vladkvit/orthograph_keyboard/right/updated--T-J24W167773A (W167773ASJ23)-ortho_right BOM  2020-12-2 (1).xls

5sets |  | updated | updated on the 1st, Feb | Designator | Package | Quantity | Designation | Specs | Value
$4.200 | $4.200 | IS31FL3733-TQLS4 5-7work days | IS31FL3733-TQLS4 5-7work days | U2 | TQFP-48-1EP_7x7mm_P0.5mm_EP5x5mm | 1 | IS31FL3733-TQ
$0.053 | $0.053 | 20K 0603 1% 1/10W，no 0.2W | 20K 0603 1% 1/10W，no 0.2W | Rext1 | R_0603_1608Metric_Pad1.05x0.95mm_HandSolder | 1 | R20k | 0.1W 1% | 20k
$0.053 | $0.105 | 1K 0603 1% 1/10W，no 0.2W | 1K 0603 1% 1/10W，no 0.2W | R5,R3 | R_0603_1608Metric_Pad1.05x0.95mm_HandSolder | 2 | R1k | 0.1W 5% | 1k
$0.053 | $0.158 | 100K 0603 1% 1/10W，no 0.2W | 100K 0603 1% 1/10W，no 0.2W | R4,R2,R1 | R_0603_1608Metric_Pad1.05x0.95mm_HandSolder | 3 | R100k | 0.1W 5% | 100k
$0.840 | $2.520 | TAJR104M035RNJ 5-7work days | TAJR104M035RNJ | C1,C4,C6 | C_0805_2012Metric_Pad1.15x1.40mm_HandSolder | 3 | CP | Tantalum, 5V, any ESR, any % | 0.1 microF
$0.735 | $2.205 | TAJR474M020RNJ 5-7work days | TAJR474M020RNJ | C2,C3,C5 | C_0805_2012Metric_Pad1.15x1.40mm_HandSolder | 3 | CP | Tantalum, 5V, any ESR, any % | 0.47 microF
$0.105 | $4.830 | LED Made in China RGB3528 Reversed https://es.aliexpress.com/item/32834911790.html | supply LED RGB3528 lighting face-down （LED敏感，建议发多点让客户替换） https://es.aliexpress.com/item/32834911790.html | K56A,K38A,K28A,K47A,K62A,K61A,K58A,K57A,K17A,K68A,K67A,K66A,K51A,K41A,K31A,K21A,K11A,K55A,K54A,K53A,K52A,K46A,K45A,K44A,K43A,K42A,K37A,K36A,K35A,K34A,K33A,K32A,K27A,K26A,K25A,K24A,K23A,K22A,K16A,K15A,K14A,K13A,K12A,K65A,K64A,K63A | RGB LED | 46 | KEYSW_RGB | RGB LED | RGB3528 Face-up
$0.063 | $2.898 | 1N4148W-TP | 1N4148W-TP | K56B,K38B,K28B,K47B,K62B,K61B,K58B,K57B,K17B,K68B,K67B,K66B,K51B,K41B,K31B,K21B,K11B,K55B,K54B,K53B,K52B,K46B,K45B,K44B,K43B,K42B,K37B,K36B,K35B,K34B,K33B,K32B,K27B,K26B,K25B,K24B,K23B,K22B,K16B,K15B,K14B,K13B,K12B,K65B,K64B,K63B | Diode | 46 | KEYSW_RGB | Diode | 1N4148W-TP
$0.945 | $0.945 | KMR231GLFS 7-10work days | KMR231GLFS 7-10work days | SW1 | SW_Push_1P1T_NO_CK_KMR2 | 1 | SW_PUSH_RESET | KMR231GLFS
$0.210 | $0.210 | PJ-320A DIP4 3.5mm | PJ-320A DIP4 3.5mm | J1 | TRRS-PJ-320A | 1 | AudioJack4 | TRRS-PJ-320A
0.5KG
 | $90.615
