vladkvit/orthograph_keyboard/left/updated-W167773ASJ20-5sets-ortho_half3 2020-8-24.xls

5sets |  | updated on 24th, August | Ref | Qnty | Value | Cmp name | Footprint | Description | Part number | Vendor
$0.105 | $0.630 | ceramic capacitor 100NF 50V 1206 | C1, C2, C3, C4, C5, C6, | 6 | 0.1 關F | CP | EIA-3216-10_Kemet-I_Pad1.58x1.35mm | Polarized capacitor Tantalum | Any | Any
$0.063 | $0.315 | 1N4148W-TP | K11, K21, K31, K41, K51, | 5 | 1N4148W-TP | Diode | SOD-123 | Diode | 1N4148W-TP | Any
$0.063 | $1.575 | 1N4148W-TP | K12, K13, K14, K15, K16, K22, K23, K24, K25, K26, K32, K33, K34, K35, K36, K42, K43, K44, K45, K46, K52, K53, K54, K55, K56, | 25 | 1N4148W-TP | Diode | SOD-123 | Diode | 1N4148W-TP | Any
$0.063 | $0.252 | 1N4148W-TP | K61, K62, K63, K64, | 4 | 1N4148W-TP | Diode | SOD-123 | Diode | 1N4148W-TP | Any
$0.063 | $0.063 | 1N4148W-TP | K65, | 1 | 1N4148W-TP | Diode | SOD-123 | Diode | 1N4148W-TP | Any
$0.063 | $0.063 | 1N4148W-TP | K66, | 1 | 1N4148W-TP | Diode | SOD-123 | Diode | 1N4148W-TP | Any
 | $0.000 | Out of stock | K11, K21, K31, K41, K51, | 5 | - | Kailh Socket | Custom | Socket | Kailh socket | Any or https://www.aliexpress.com/item/10000252734106.html
 | $0.000 | Out of stock | K12, K13, K14, K15, K16, K22, K23, K24, K25, K26, K32, K33, K34, K35, K36, K42, K43, K44, K45, K46, K52, K53, K54, K55, K56, | 25 | - | Kailh Socket | Custom | Socket | Kailh socket | Any or https://www.aliexpress.com/item/10000252734106.html
 | $0.000 | Out of stock | K61, K62, K63, K64, | 4 | - | Kailh Socket | Custom | Socket | Kailh socket | Any or https://www.aliexpress.com/item/10000252734106.html
 | $0.000 | Out of stock | K65, | 1 | - | Kailh Socket | Custom | Socket | Kailh socket | Any or https://www.aliexpress.com/item/10000252734106.html
 | $0.000 | Out of stock | K66, | 1 | - | Kailh Socket | Custom | Socket | Kailh socket | Any or https://www.aliexpress.com/item/10000252734106.html
$0.053 | $0.158 | 100K 0805 1% | R1, R2, R4, | 3 | R100k | R | 2012 | Resistor | Any | Any
$0.053 | $0.105 | 1K 0805 1% | R3, R5, | 2 | R1k | R | 2012 | Resistor | Any | Any
$0.053 | $0.053 | 20K 0805 1% | Rext1, | 1 | R20k | R | 2012 | Resistor | Any | Any
$0.525 | $0.525 | KMR231GLFS | SW1, | 1 | SW_Push_1P1T_NO_CK_KMR2 | SW_PUSH | 4.60mm x 2.80mm | Momentary Push button | KMR231GLFS or any KMR2 series | Any or https://www.aliexpress.com/item/4001159293893.html
$4.200 | $4.200 | IS31FL3733-TQLS4 贸泽 5-7work days | U2, | 1 | IS31FL3733-TQ | IS31FL3733-TQ | Package_QFP:TQFP-48-1EP_7x7mm_P0.5mm_EP5x5mm | 12x16 LED matrix driver with 8-bit PWM and breathing, TQFP-48 | IS31FL3733-TQ | Any or https://www.alibaba.com/product-detail/Integrated-Circuit-IS31FL3733-TQLS4-TR-_1600089956957.html
$0.210 | $0.210 | PJ-320A DIP4 3.5mm | J1 | 1 | TRRS-PJ-320A | TRRS-PJ-320A | Custom | Audio Jack | TRRS-PJ-320A | Any or https://www.aliexpress.com/item/33029465106.html
 |  |  | SUM | 87
 | $40.740
0.5KG
