vladkvit/orthograph_keyboard/left/svg/ortho_half-Eco2_User.dxf

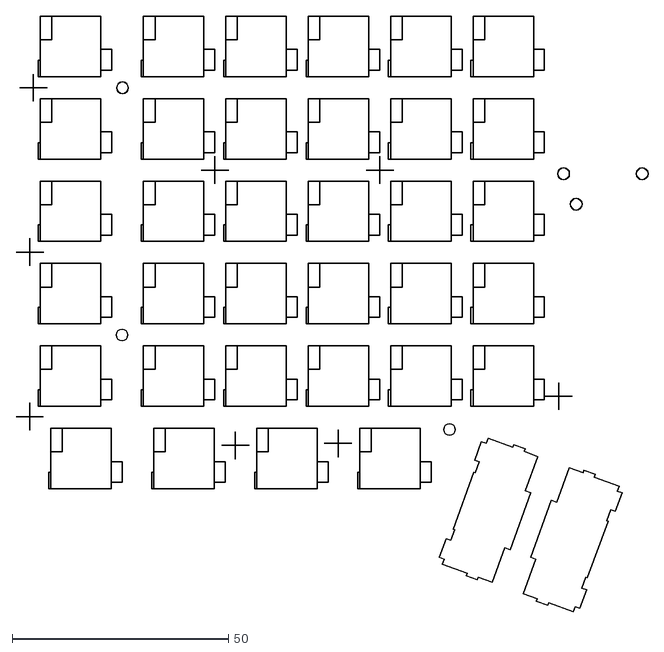
[picture p1: CAD file, 2022-06-20]
left/svg/ortho_half-Eco2_User.dxf
146.1 x 137.7
