vladkvit/orthograph_keyboard/right/ortho_right.step

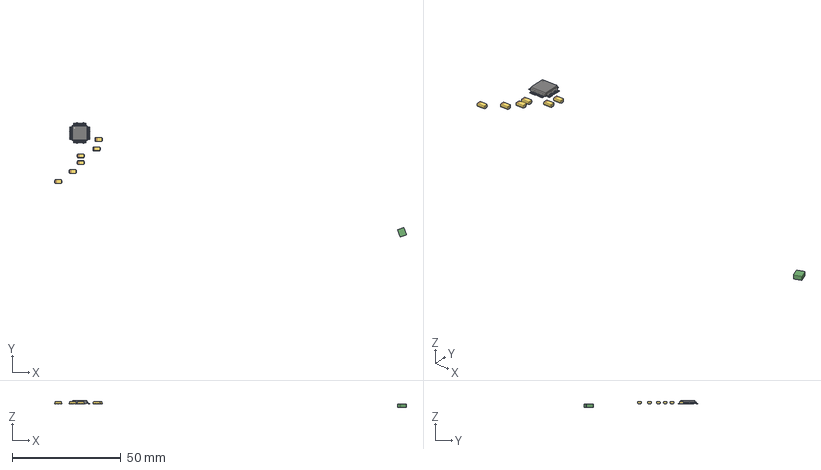
[picture p2: CAD file, 2020-11-28]
right/ortho_right.step
161.8 x 52.4 x 3.25 mm
