vladkvit/orthograph_keyboard/right/out/ortho_right-NPTH-drl_map.dxf

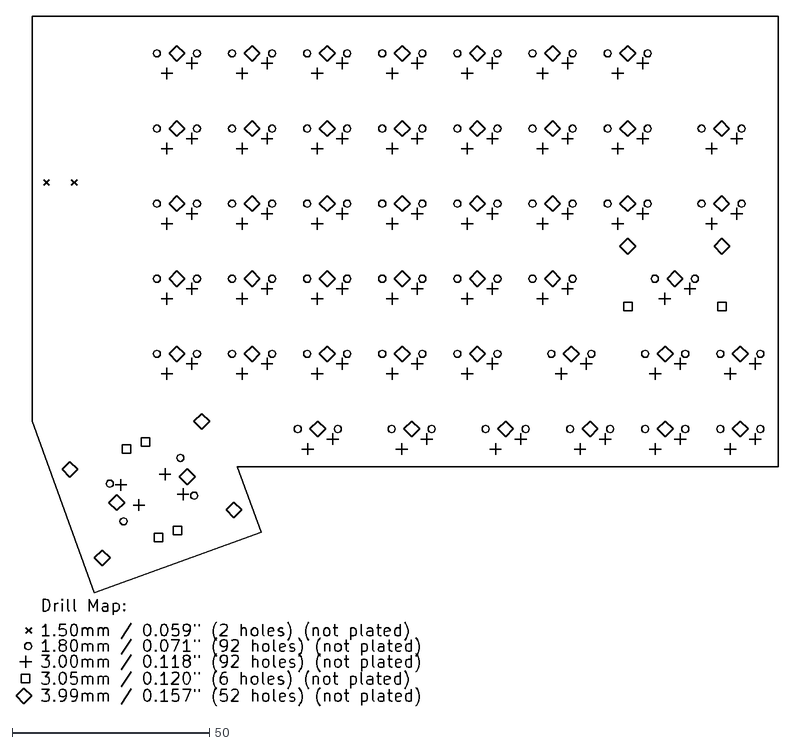
[picture p3: CAD file, 2021-03-09]
right/out/ortho_right-NPTH-drl_map.dxf
193.2 x 174.8
