vladkvit/orthograph_keyboard/left/svg/ortho_half-Edge_Cuts.dxf

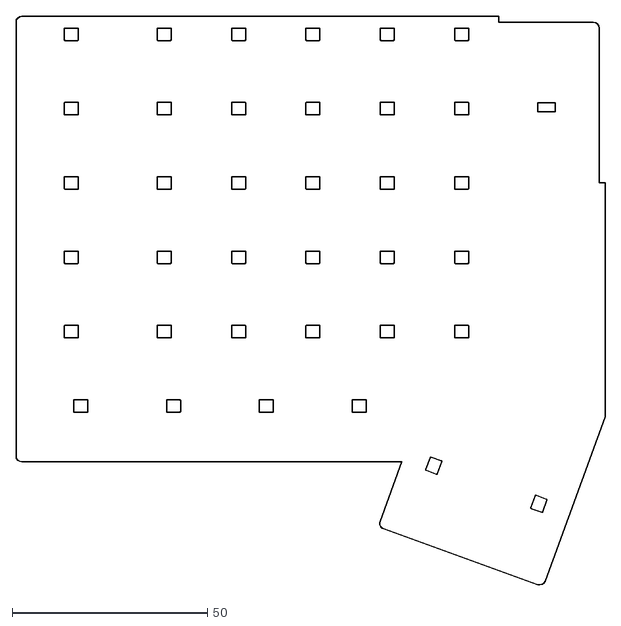
[picture p4: CAD file, 2022-06-20]
left/svg/ortho_half-Edge_Cuts.dxf
150.9 x 145.9
