vladkvit/orthograph_keyboard/right/out/ortho_right-Edge_Cuts.dxf

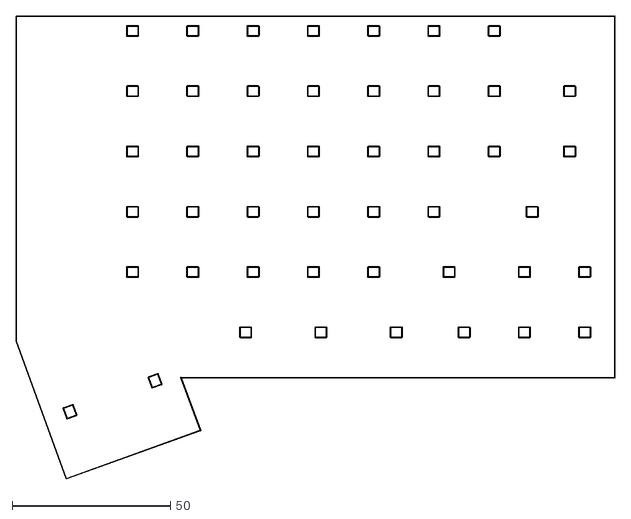
[picture p5: CAD file, 2021-03-09]
right/out/ortho_right-Edge_Cuts.dxf
189.3 x 146.2
