vladkvit/orthograph_keyboard/right/out/ortho_right-PTH-drl_map.dxf

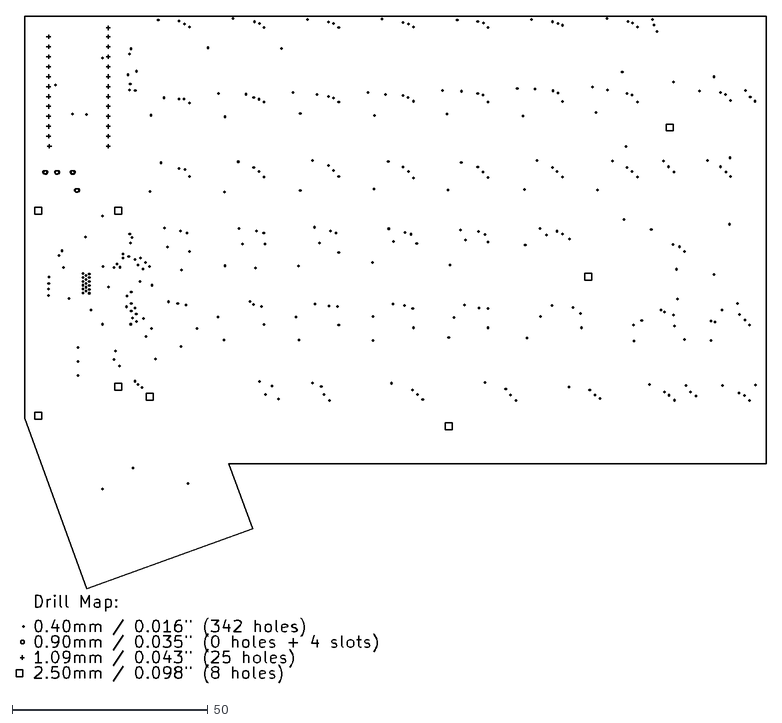
[picture p6: CAD file, 2021-03-09]
right/out/ortho_right-PTH-drl_map.dxf
191.4 x 170.2
