vladkvit/orthograph_keyboard/right/out/ortho_right-Eco2_User.dxf

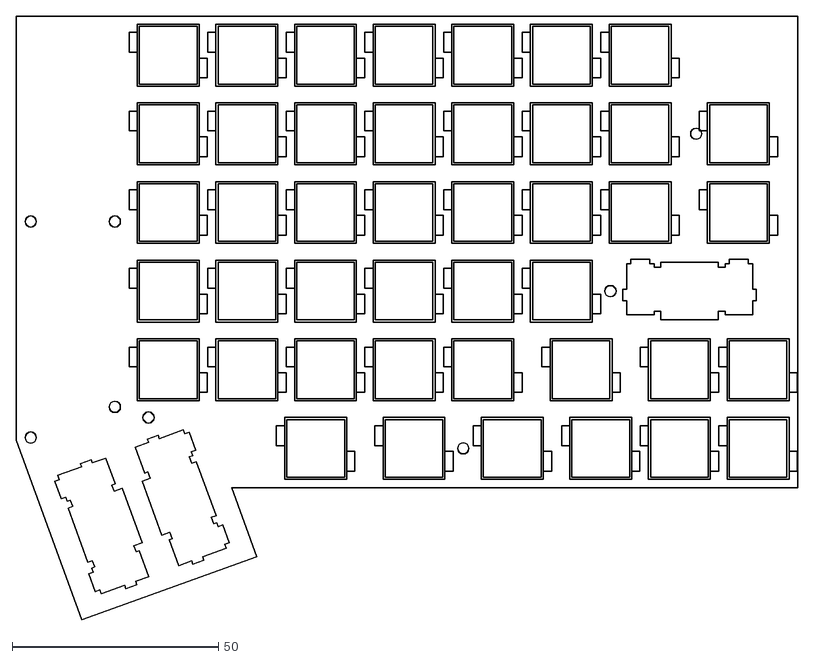
[picture p7: CAD file, 2021-03-09]
right/out/ortho_right-Eco2_User.dxf
189.2 x 146.1
