vladkvit/orthograph_keyboard/right/out/ortho_right-Edge_Cuts inkscape.dxf

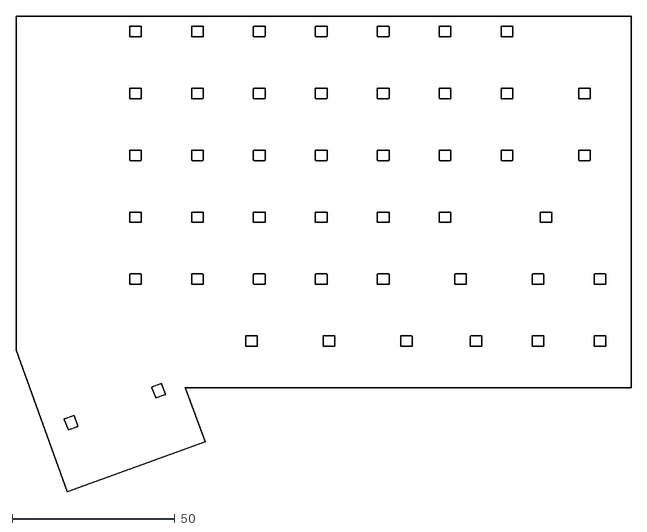
[picture p8: CAD file, 2021-03-09]
right/out/ortho_right-Edge_Cuts inkscape.dxf
189.2 x 146.1
