vladkvit/orthograph_keyboard/(list of files, cad)

Other CAD files:
left/frame schematics/bottom v2.dwg
spacer.dwg
bottom.dwg
plate.dwg
