vladkvit/orthograph_keyboard/left/frame schematics/bottom Drawing, extra hole, final part.pdf

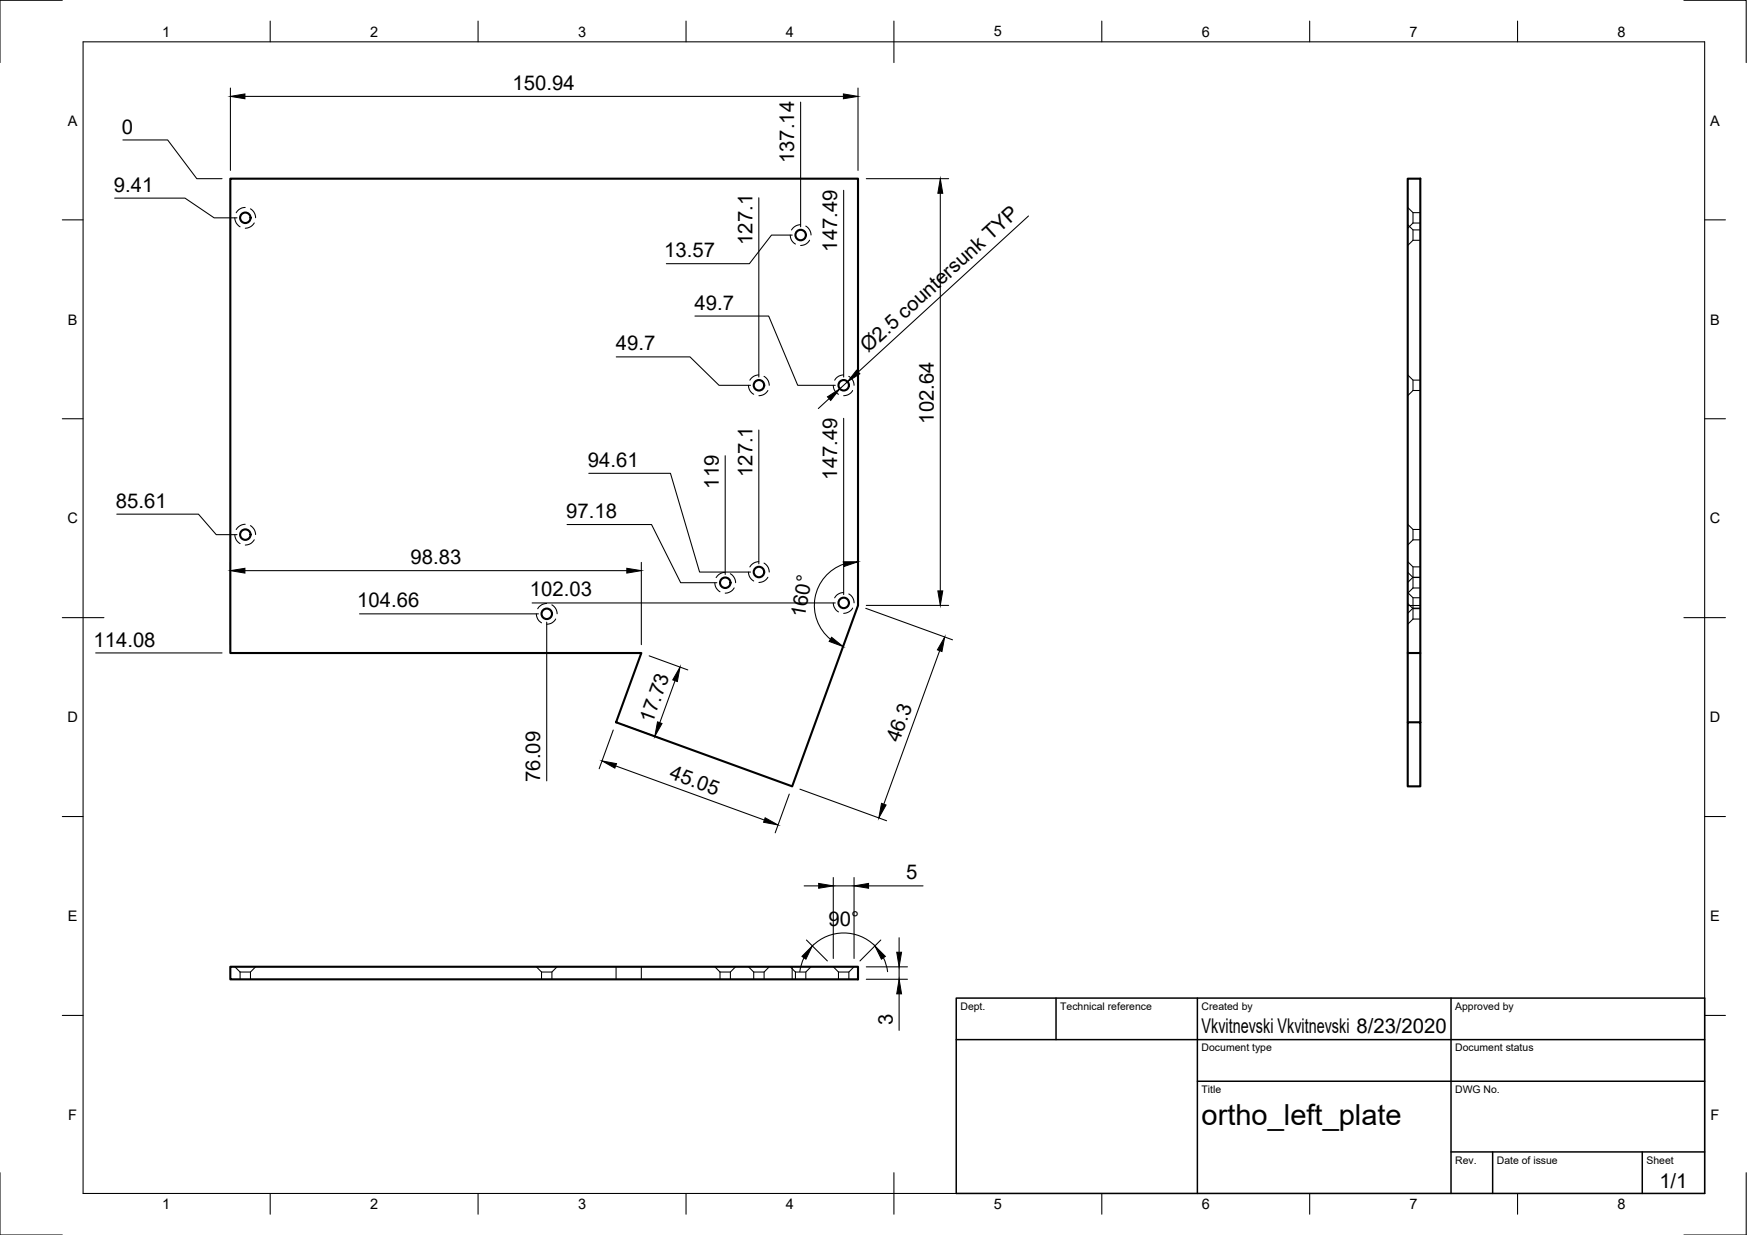
[picture p9: page 1]
Ø2.5 countersunk TYP

Dept. | Technical reference | Created by Vkvitnevski Vkvitnevski 8/23/2020 | Approved by

Document type | Document status

Title ortho_left_plate | DWG No.

Rev. | Date of issue | Sheet 1/1
