vladkvit/orthograph_keyboard/left/frame schematics/ortho_left_plate Drawing spacer.pdf

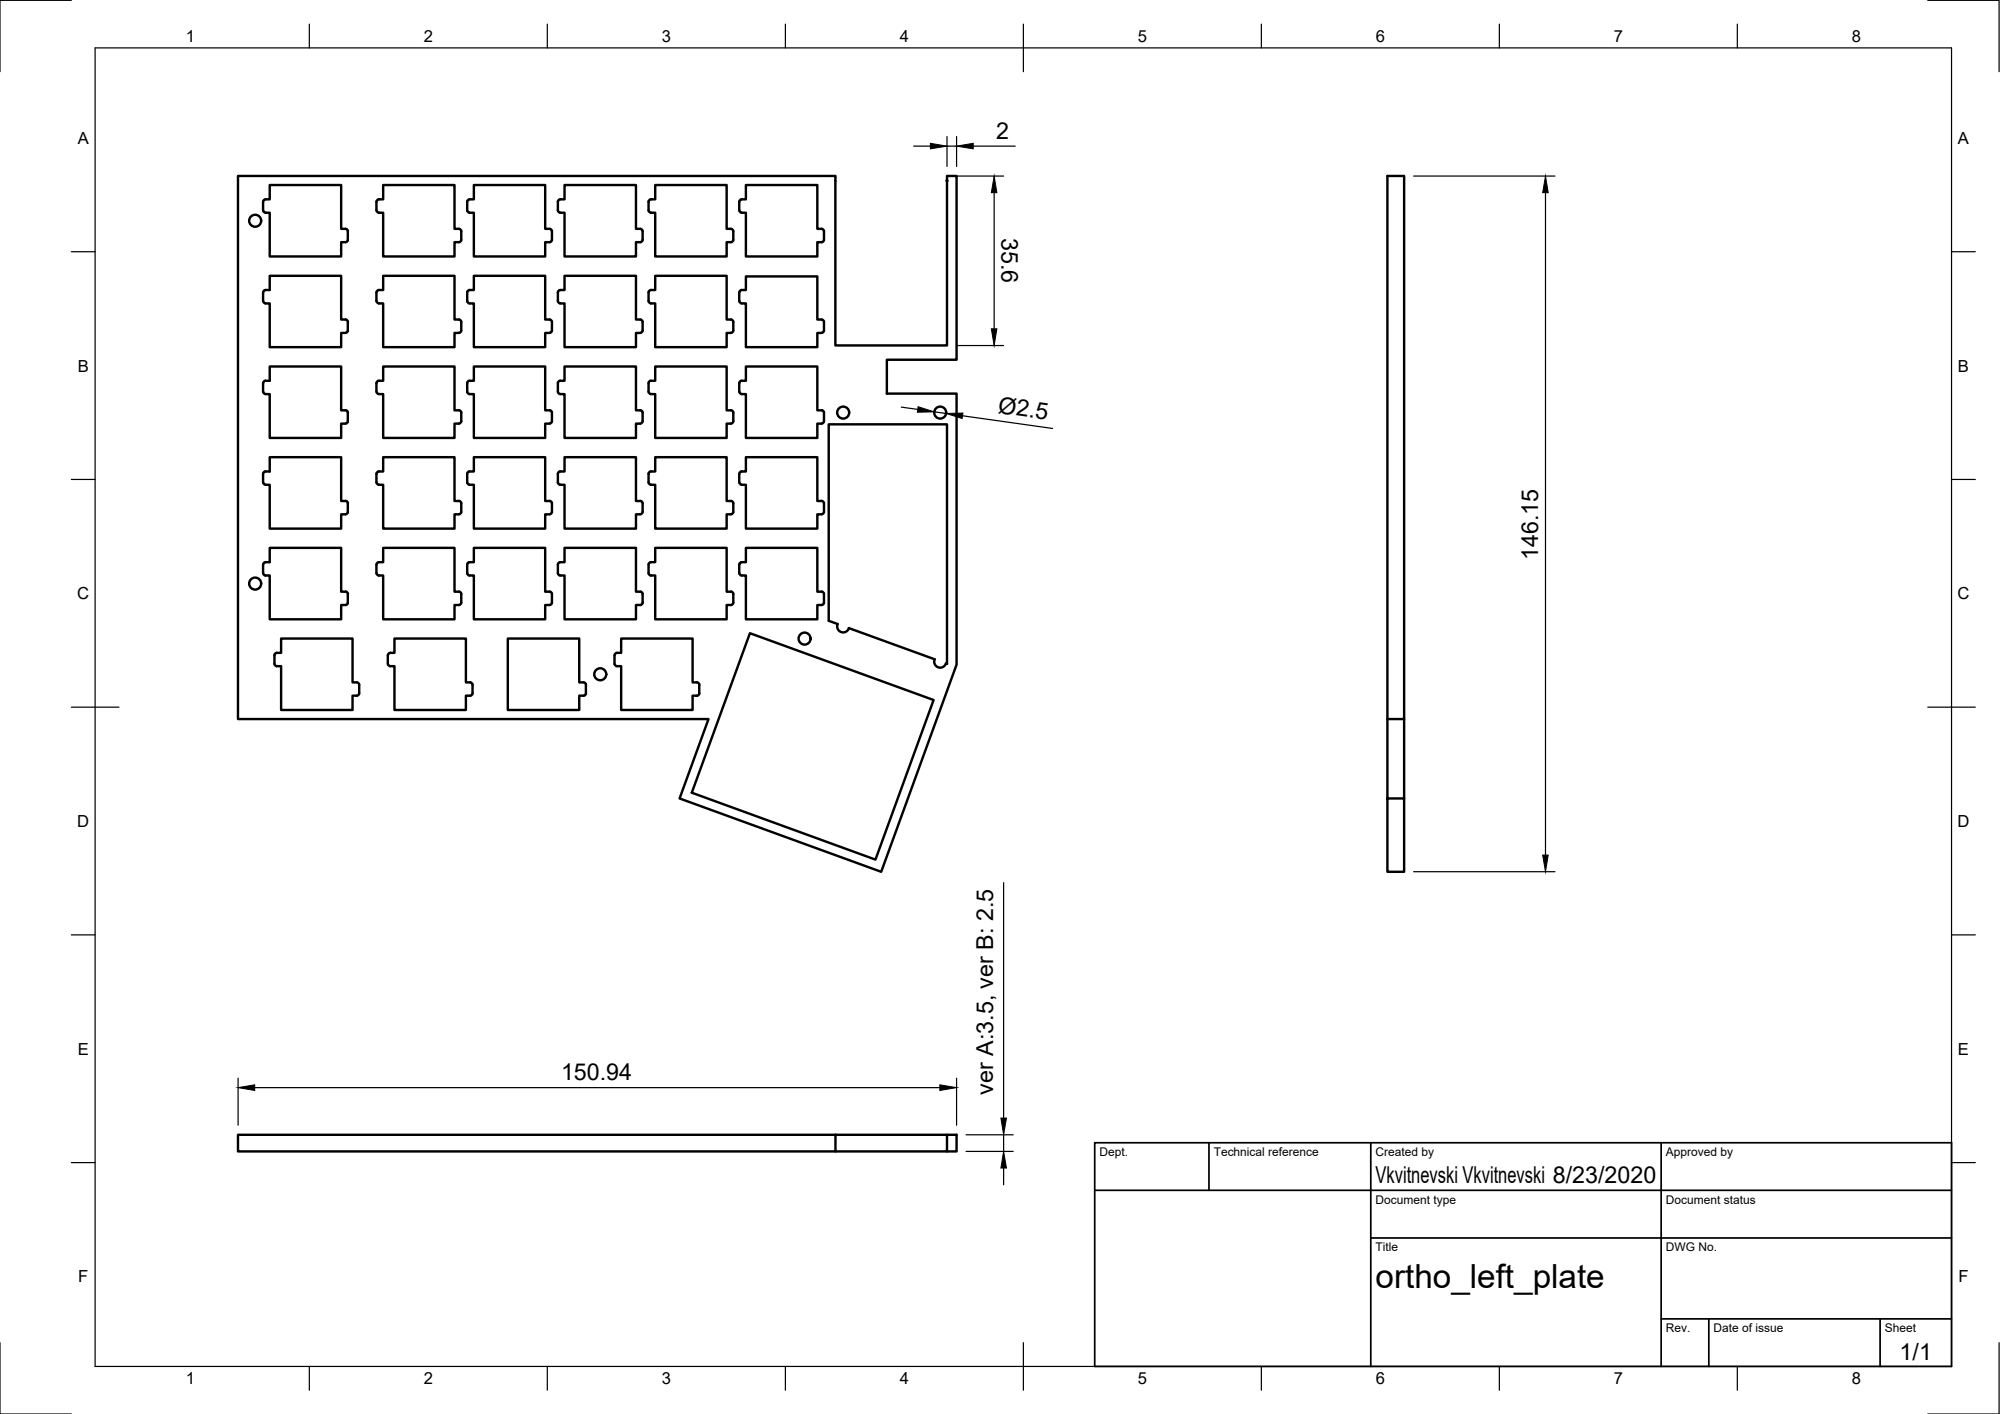
[picture p10: page 1]
146.15 ver A:3.5, ver B: 2.5

Dept. | Technical reference | Created by Vkvitnevski Vkvitnevski 8/23/2020 | Approved by

Document type | Document status

Title ortho_left_plate | DWG No.

Rev. | Date of issue | Sheet 1/1
