vladkvit/orthograph_keyboard/left/ortho_half.kicad_pcb

## KiCad design left/ortho_half.kicad_pcb (2025-12-19)

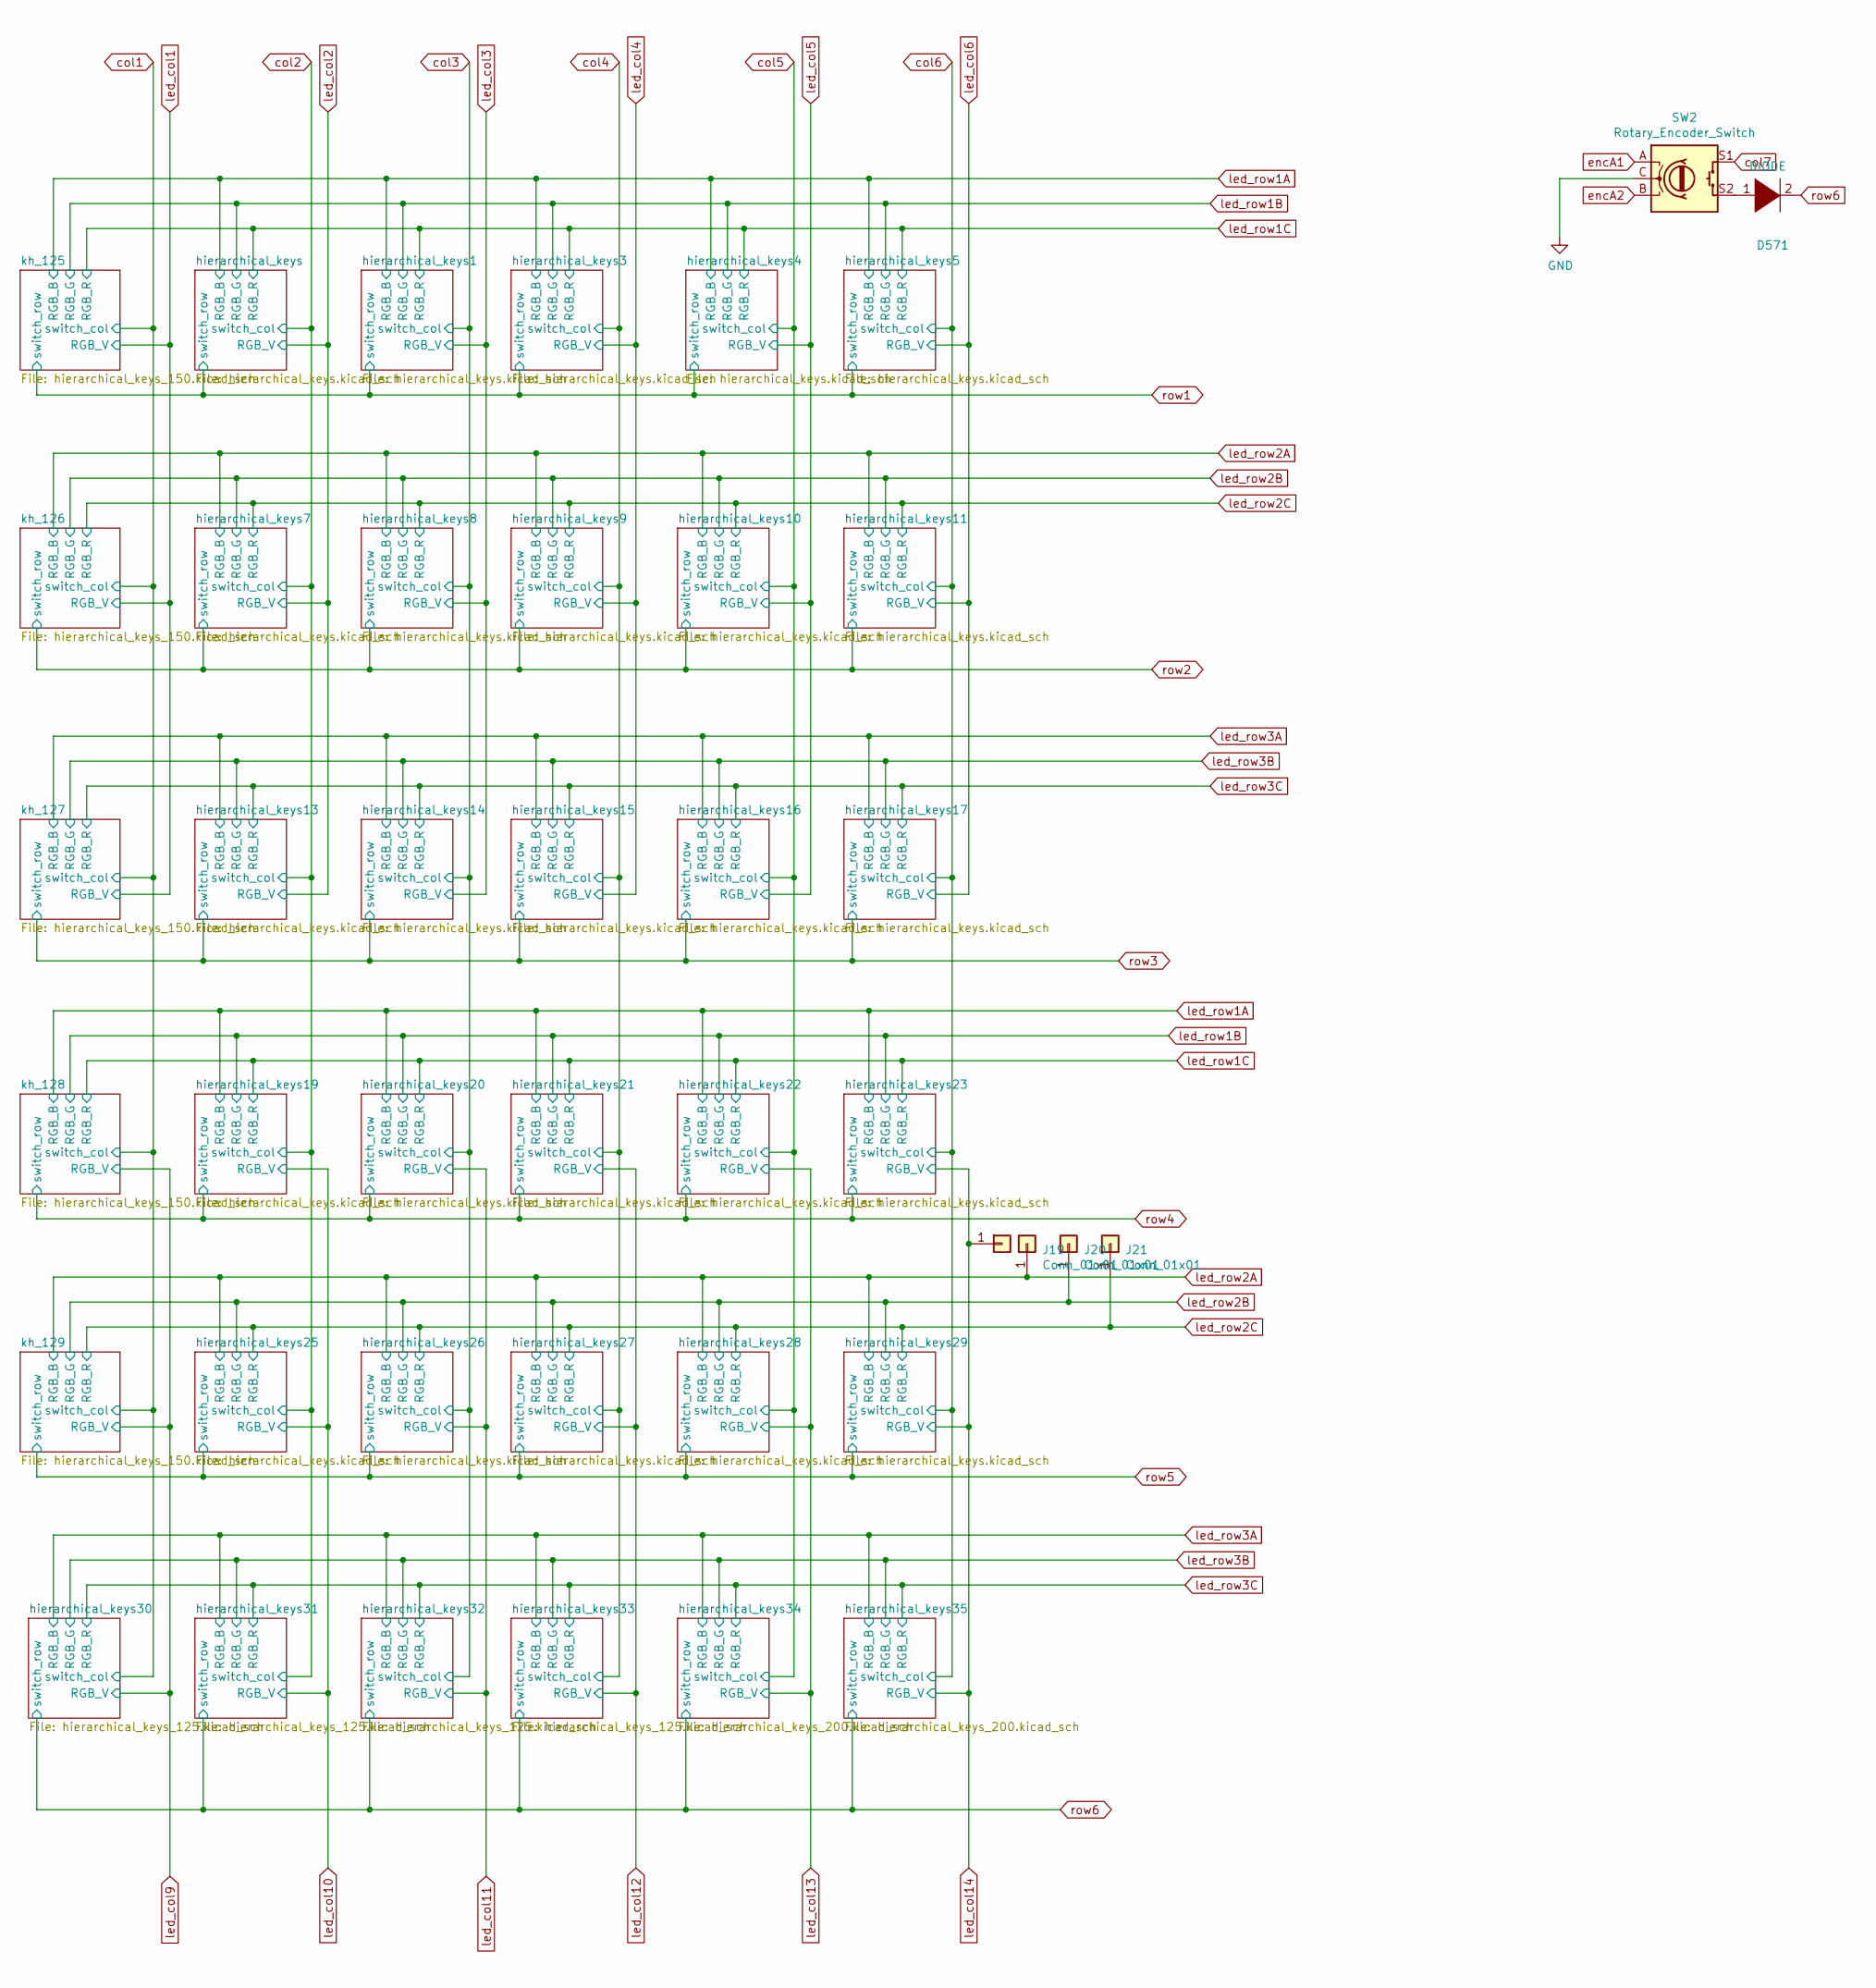
[picture p11: schematic switches.kicad_sch]

Parts:
D571: DIODE; D_SOD-123; LCSC C77978
J18, J19, J20, J21: Conn_01x01; TestPoint_Pad_D1.5mm
SW2: Rotary_Encoder_Switch; RotaryEncoderEC11_MX_combo; LCSC C470742

Connections:
GND: SW2.C; also elsewhere on the board
unnamed: D571.1 (K), SW2.S2
col7: SW2.S1; also elsewhere on the board
encA1: SW2.A; also elsewhere on the board
encA2: SW2.B; also elsewhere on the board
led_col14: J18.1; also elsewhere on the board
led_row2A: J19.1; also elsewhere on the board
led_row2B: J20.1; also elsewhere on the board
led_row2C: J21.1; also elsewhere on the board
row6: D571.2 (A); also elsewhere on the board

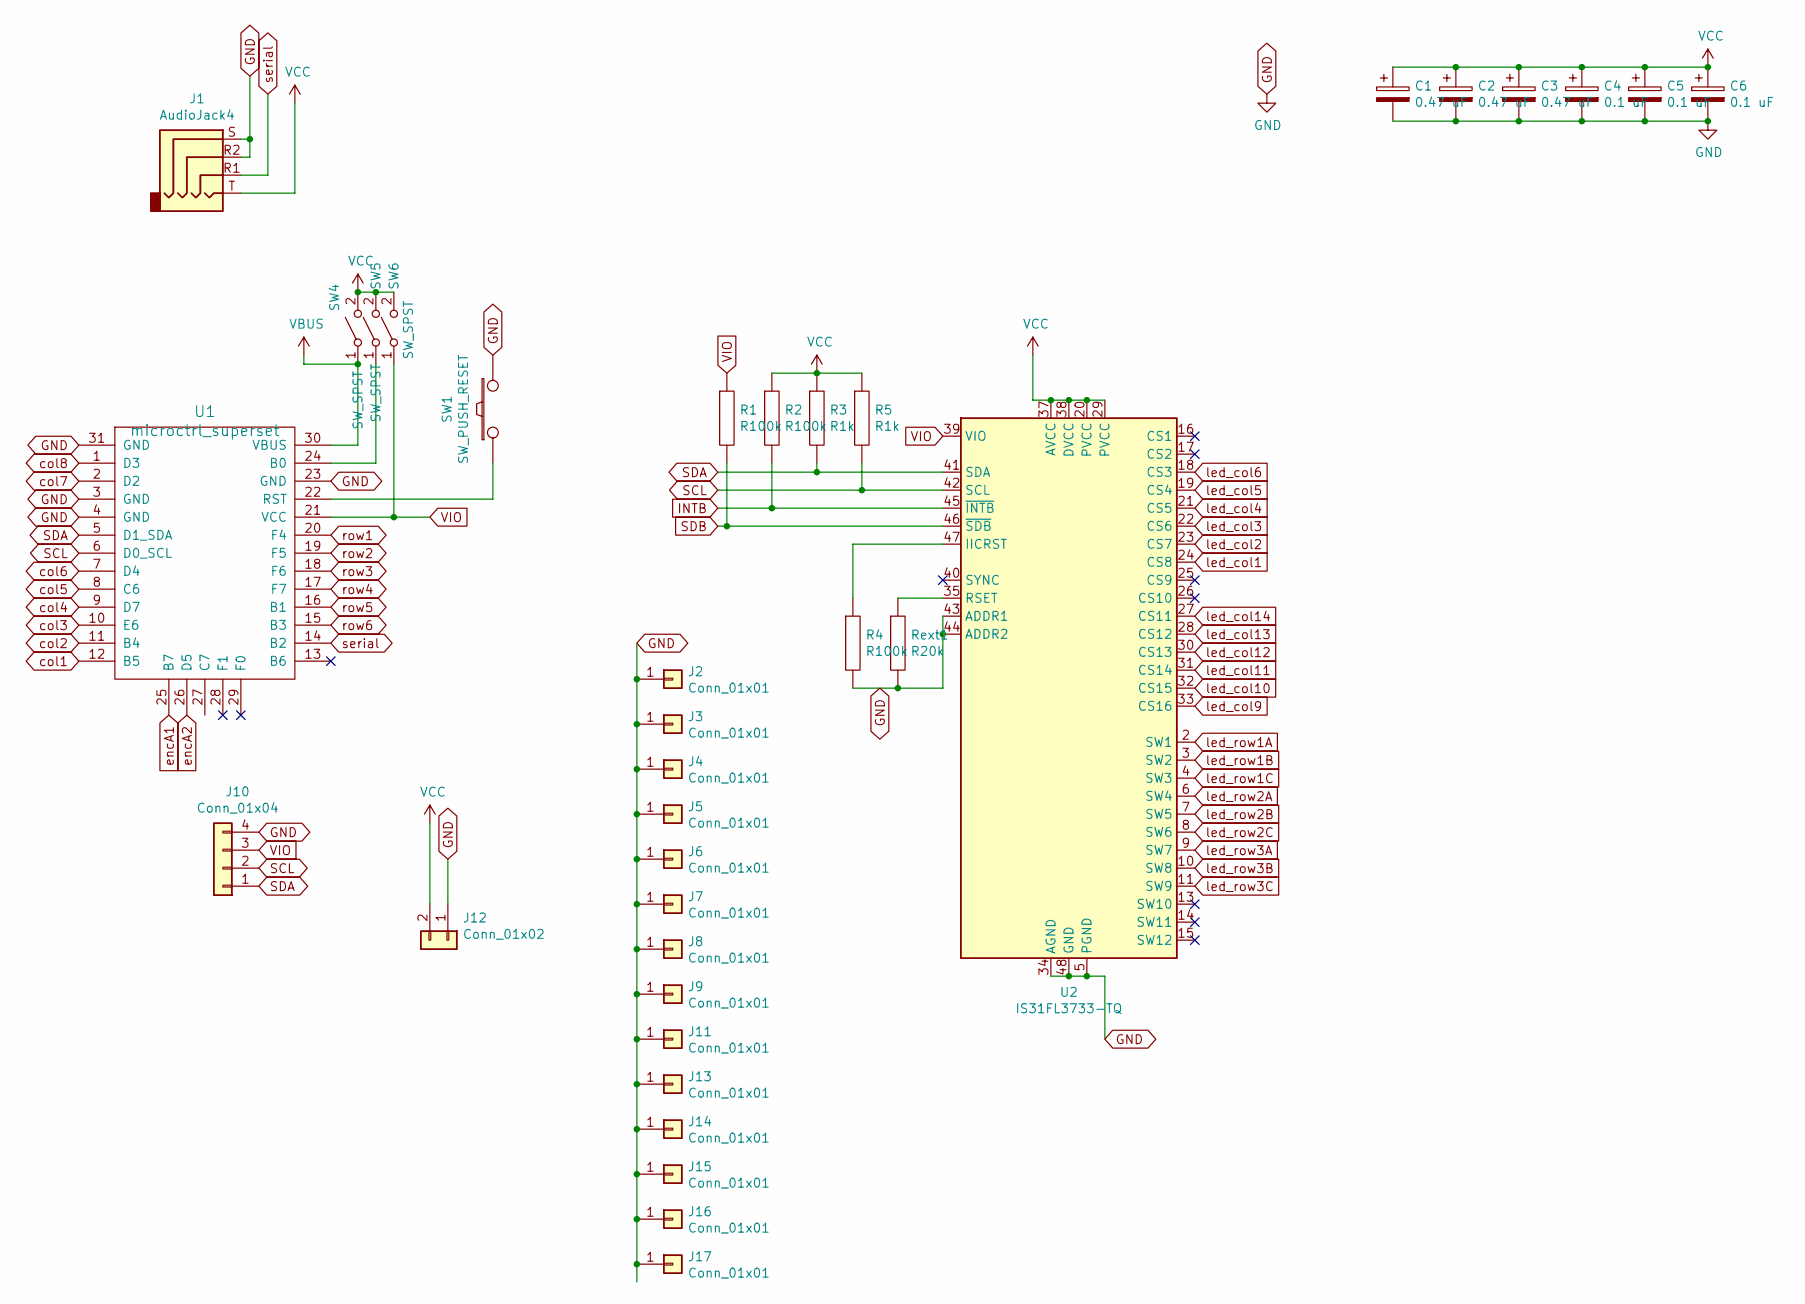
[picture p12: schematic Controller.kicad_sch]

Parts:
C1, C2, C3: 0.47 uF; C_0805_2012Metric; LCSC C49955
C4, C5, C6: 0.1 uF; C_0805_2012Metric; LCSC C49678
J1: AudioJack4; TRRS-PJ-320D; LCSC C431535
J2, J3, J5, J6, J7, J9, J11, J17: Conn_01x01; SMTSO_mount_m2.5; LCSC C2916379
J4, J8: Conn_01x01; m2.5_hole
J10: Conn_01x04; PinHeader_1x04_P2.54mm_Vertical
J12: Conn_01x02; battery_solder_point
J13, J14, J15, J16: Conn_01x01; standoff_m2.5
R1, R2, R4: R100k; R_0603_1608Metric; LCSC C25803
R3, R5: R1k; R_0603_1608Metric; LCSC C21190
Rext1: R20k; R_0603_1608Metric; LCSC C4184
SW1: SW_PUSH_RESET; SW_Push_1P1T_NO_CK_KMR2; LCSC C99271
SW4, SW5, SW6: SW_SPST; SolderJumper-2_P1.3mm_Open_RoundedPad1.0x1.5mm
U1: microctrl_superset; microcontroller_eliteC_ninenano
U2: IS31FL3733-TQ; TQFP-48-1EP_7x7mm_P0.5mm_EP5x5mm; LCSC C17348851

Connections:
GND: C1.2, C2.2, C3.2, C4.2, C5.2, C6.2, J1.R2, J1.S, J2.1, J3.1, J4.1, J5.1, J6.1, J7.1, J8.1, J9.1, J10.4, J11.1, J12.1, J13.1, J14.1, J15.1, J16.1, J17.1, R4.2, Rext1.2, SW1.2, U1.3 (GND), U1.4 (GND), U1.23 (GND), U1.31 (GND), U2.5 (PGND), U2.12 (PGND), U2.34 (AGND), U2.43 (ADDR1), U2.44 (ADDR2), U2.48 (GND), U2.49 (GND); also elsewhere on the board
INTB: R2.2, U2.45 (~INTB)
unnamed: SW5.1 (A), U1.24 (B0)
unnamed: SW1.1, U1.22 (RST)
unnamed: R4.1, U2.47 (IICRST)
unnamed: Rext1.1, U2.35 (RSET)
SCL: J10.2, R5.2, U1.6 (D0_SCL), U2.42 (SCL)
SDA: J10.1, R3.2, U1.5 (D1_SDA), U2.41 (SDA)
SDB: R1.2, U2.46 (~SDB)
VBUS: SW4.1 (A), U1.30 (VBUS)
VCC: C1.1, C2.1, C3.1, C4.1, C5.1, C6.1, J1.T, J12.2, R2.1, R3.1, R5.1, SW4.2 (B), SW5.2 (B), SW6.2 (B), U2.20 (PVCC), U2.29 (PVCC), U2.37 (AVCC), U2.38 (DVCC)
VIO: J10.3, R1.1, SW6.1 (A), U1.21 (VCC), U2.39 (VIO)
col1: U1.12 (B5); also elsewhere on the board
col2: U1.11 (B4); also elsewhere on the board
col3: U1.10 (E6); also elsewhere on the board
col4: U1.9 (D7); also elsewhere on the board
col5: U1.8 (C6); also elsewhere on the board
col6: U1.7 (D4); also elsewhere on the board
col7: U1.2 (D2); also elsewhere on the board
col8: U1.1 (D3)
encA1: U1.25 (B7); also elsewhere on the board
encA2: U1.26 (D5); also elsewhere on the board
led_col1: U2.24 (CS8); also elsewhere on the board
led_col2: U2.23 (CS7); also elsewhere on the board
led_col3: U2.22 (CS6); also elsewhere on the board
led_col4: U2.21 (CS5); also elsewhere on the board
led_col5: U2.19 (CS4); also elsewhere on the board
led_col6: U2.18 (CS3); also elsewhere on the board
led_col9: U2.33 (CS16); also elsewhere on the board
led_col10: U2.32 (CS15); also elsewhere on the board
led_col11: U2.31 (CS14); also elsewhere on the board
led_col12: U2.30 (CS13); also elsewhere on the board
led_col13: U2.28 (CS12); also elsewhere on the board
led_col14: U2.27 (CS11); also elsewhere on the board
led_row1A: U2.2 (SW1); also elsewhere on the board
led_row1B: U2.3 (SW2); also elsewhere on the board
led_row1C: U2.4 (SW3); also elsewhere on the board
led_row2A: U2.6 (SW4); also elsewhere on the board
led_row2B: U2.7 (SW5); also elsewhere on the board
led_row2C: U2.8 (SW6); also elsewhere on the board
led_row3A: U2.9 (SW7); also elsewhere on the board
led_row3B: U2.10 (SW8); also elsewhere on the board
led_row3C: U2.11 (SW9); also elsewhere on the board
row1: U1.20 (F4); also elsewhere on the board
row2: U1.19 (F5); also elsewhere on the board
row3: U1.18 (F6); also elsewhere on the board
row4: U1.17 (F7); also elsewhere on the board
row5: U1.16 (B1); also elsewhere on the board
row6: U1.15 (B3); also elsewhere on the board
serial: J1.R1, U1.14 (B2)

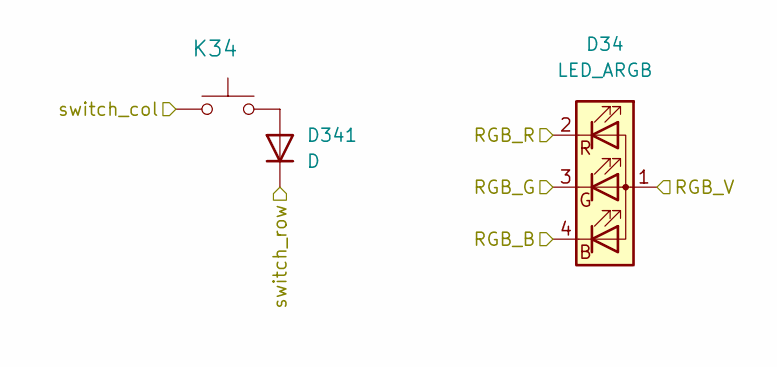
[picture p13: schematic hierarchical_keys.kicad_sch]

Parts:
D34: LED_ARGB; MX_RGB
D341: D; D_SOD-123
K34: KEYSW; MX_switch_hotswap

Connections:
unnamed: D341.2 (A), K34.2
col4: K34.1; also elsewhere on the board
led_col4: D34.1 (A); also elsewhere on the board
led_row3A: D34.4 (BK); also elsewhere on the board
led_row3B: D34.3 (GK); also elsewhere on the board
led_row3C: D34.2 (RK); also elsewhere on the board
row3: D341.1 (K); also elsewhere on the board

Parts of its further copies:
D12, D13, D14, D15, D16, D22, D23, D24, D25, D26, D32, D33, D35, D36, D42, D43, D44, D45, D46, D52, D53, D54, D55, D56, D61, D62, D63, D64, D65, D66: LED_ARGB; MX_RGB
D121, D131, D141, D151, D161, D221, D231, D241, D251, D261, D321, D331, D351, D361, D421, D431, D441, D451, D461, D521, D531, D541, D551, D561, D611, D621, D631, D641, D651, D661: D; D_SOD-123
K12, K13, K14, K15, K16, K22, K23, K24, K25, K26, K32, K33, K35, K36, K42, K43, K44, K45, K46, K52, K53, K54, K55, K56, K61, K62, K63, K64, K65, K66: KEYSW; MX_switch_hotswap

Connections of its further copies:
unnamed: D121.2 (A), K12.2
unnamed: D131.2 (A), K13.2
unnamed: D141.2 (A), K14.2
unnamed: D151.2 (A), K15.2
unnamed: D161.2 (A), K16.2
unnamed: D221.2 (A), K22.2
unnamed: D231.2 (A), K23.2
unnamed: D241.2 (A), K24.2
unnamed: D251.2 (A), K25.2
unnamed: D261.2 (A), K26.2
unnamed: D321.2 (A), K32.2
unnamed: D331.2 (A), K33.2
unnamed: D351.2 (A), K35.2
unnamed: D361.2 (A), K36.2
unnamed: D421.2 (A), K42.2
unnamed: D431.2 (A), K43.2
unnamed: D441.2 (A), K44.2
unnamed: D451.2 (A), K45.2
unnamed: D461.2 (A), K46.2
unnamed: D521.2 (A), K52.2
unnamed: D531.2 (A), K53.2
unnamed: D541.2 (A), K54.2
unnamed: D551.2 (A), K55.2
unnamed: D561.2 (A), K56.2
unnamed: D611.2 (A), K61.2
unnamed: D621.2 (A), K62.2
unnamed: D631.2 (A), K63.2
unnamed: D641.2 (A), K64.2
unnamed: D651.2 (A), K65.2
unnamed: D661.2 (A), K66.2
col1: K61.1; also elsewhere on the board
col2: K12.1, K22.1, K32.1, K42.1, K52.1, K62.1; also elsewhere on the board
col3: K13.1, K23.1, K33.1, K43.1, K53.1, K63.1; also elsewhere on the board
col4: K14.1, K24.1, K44.1, K54.1, K64.1; also elsewhere on the board
col5: K15.1, K25.1, K35.1, K45.1, K55.1, K65.1; also elsewhere on the board
col6: K16.1, K26.1, K36.1, K46.1, K56.1, K66.1; also elsewhere on the board
led_col2: D12.1 (A), D22.1 (A), D32.1 (A); also elsewhere on the board
led_col3: D13.1 (A), D23.1 (A), D33.1 (A); also elsewhere on the board
led_col4: D14.1 (A), D24.1 (A); also elsewhere on the board
led_col5: D15.1 (A), D25.1 (A), D35.1 (A); also elsewhere on the board
led_col6: D16.1 (A), D26.1 (A), D36.1 (A); also elsewhere on the board
led_col9: D61.1 (A); also elsewhere on the board
led_col10: D42.1 (A), D52.1 (A), D62.1 (A); also elsewhere on the board
led_col11: D43.1 (A), D53.1 (A), D63.1 (A); also elsewhere on the board
led_col12: D44.1 (A), D54.1 (A), D64.1 (A); also elsewhere on the board
led_col13: D45.1 (A), D55.1 (A), D65.1 (A); also elsewhere on the board
led_col14: D46.1 (A), D56.1 (A), D66.1 (A); also elsewhere on the board
led_row1A: D12.4 (BK), D13.4 (BK), D14.4 (BK), D15.4 (BK), D16.4 (BK), D42.4 (BK), D43.4 (BK), D44.4 (BK), D45.4 (BK), D46.4 (BK); also elsewhere on the board
led_row1B: D12.3 (GK), D13.3 (GK), D14.3 (GK), D15.3 (GK), D16.3 (GK), D42.3 (GK), D43.3 (GK), D44.3 (GK), D45.3 (GK), D46.3 (GK); also elsewhere on the board
led_row1C: D12.2 (RK), D13.2 (RK), D14.2 (RK), D15.2 (RK), D16.2 (RK), D42.2 (RK), D43.2 (RK), D44.2 (RK), D45.2 (RK), D46.2 (RK); also elsewhere on the board
led_row2A: D22.4 (BK), D23.4 (BK), D24.4 (BK), D25.4 (BK), D26.4 (BK), D52.4 (BK), D53.4 (BK), D54.4 (BK), D55.4 (BK), D56.4 (BK); also elsewhere on the board
led_row2B: D22.3 (GK), D23.3 (GK), D24.3 (GK), D25.3 (GK), D26.3 (GK), D52.3 (GK), D53.3 (GK), D54.3 (GK), D55.3 (GK), D56.3 (GK); also elsewhere on the board
led_row2C: D22.2 (RK), D23.2 (RK), D24.2 (RK), D25.2 (RK), D26.2 (RK), D52.2 (RK), D53.2 (RK), D54.2 (RK), D55.2 (RK), D56.2 (RK); also elsewhere on the board
led_row3A: D32.4 (BK), D33.4 (BK), D35.4 (BK), D36.4 (BK), D61.4 (BK), D62.4 (BK), D63.4 (BK), D64.4 (BK), D65.4 (BK), D66.4 (BK); also elsewhere on the board
led_row3B: D32.3 (GK), D33.3 (GK), D35.3 (GK), D36.3 (GK), D61.3 (GK), D62.3 (GK), D63.3 (GK), D64.3 (GK), D65.3 (GK), D66.3 (GK); also elsewhere on the board
led_row3C: D32.2 (RK), D33.2 (RK), D35.2 (RK), D36.2 (RK), D61.2 (RK), D62.2 (RK), D63.2 (RK), D64.2 (RK), D65.2 (RK), D66.2 (RK); also elsewhere on the board
row1: D121.1 (K), D131.1 (K), D141.1 (K), D151.1 (K), D161.1 (K); also elsewhere on the board
row2: D221.1 (K), D231.1 (K), D241.1 (K), D251.1 (K), D261.1 (K); also elsewhere on the board
row3: D321.1 (K), D331.1 (K), D351.1 (K), D361.1 (K); also elsewhere on the board
row4: D421.1 (K), D431.1 (K), D441.1 (K), D451.1 (K), D461.1 (K); also elsewhere on the board
row5: D521.1 (K), D531.1 (K), D541.1 (K), D551.1 (K), D561.1 (K); also elsewhere on the board
row6: D611.1 (K), D621.1 (K), D631.1 (K), D641.1 (K), D651.1 (K), D661.1 (K); also elsewhere on the board

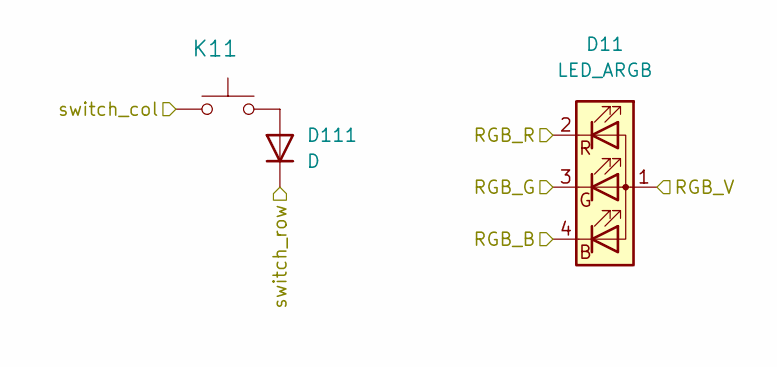
[picture p14: schematic hierarchical_keys_150.kicad_sch]

Parts:
D11: LED_ARGB; MX_RGB
D111: D; D_SOD-123
K11: KEYSW; MX_switch_hotswap_150

Connections:
unnamed: D111.2 (A), K11.2
col1: K11.1; also elsewhere on the board
led_col1: D11.1 (A); also elsewhere on the board
led_row1A: D11.4 (BK); also elsewhere on the board
led_row1B: D11.3 (GK); also elsewhere on the board
led_row1C: D11.2 (RK); also elsewhere on the board
row1: D111.1 (K); also elsewhere on the board

Parts of its further copies:
D21, D41, D51: LED_ARGB; MX_RGB
D211, D411, D511: D; D_SOD-123
K21, K41, K51: KEYSW; MX_switch_hotswap_150

Connections of its further copies:
unnamed: D211.2 (A), K21.2
unnamed: D411.2 (A), K41.2
unnamed: D511.2 (A), K51.2
col1: K21.1, K41.1, K51.1; also elsewhere on the board
led_col1: D21.1 (A); also elsewhere on the board
led_col9: D41.1 (A), D51.1 (A); also elsewhere on the board
led_row1A: D41.4 (BK); also elsewhere on the board
led_row1B: D41.3 (GK); also elsewhere on the board
led_row1C: D41.2 (RK); also elsewhere on the board
led_row2A: D21.4 (BK), D51.4 (BK); also elsewhere on the board
led_row2B: D21.3 (GK), D51.3 (GK); also elsewhere on the board
led_row2C: D21.2 (RK), D51.2 (RK); also elsewhere on the board
row2: D211.1 (K); also elsewhere on the board
row4: D411.1 (K); also elsewhere on the board
row5: D511.1 (K); also elsewhere on the board

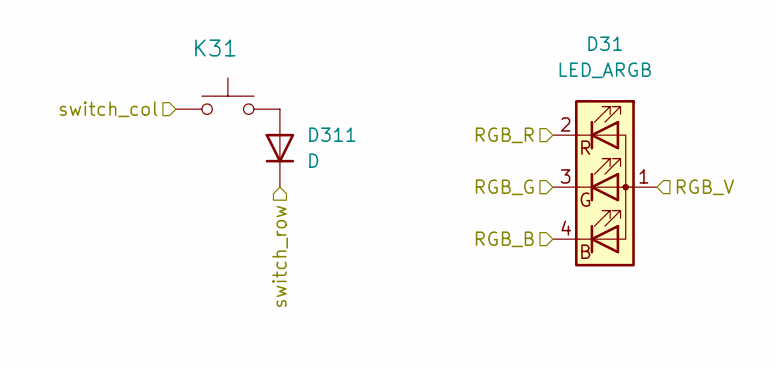
[picture p15: schematic hierarchical_keys_200.kicad_sch]

Parts:
D31: LED_ARGB; MX_RGB
D311: D; D_SOD-123
K31: KEYSW; MX_switch_hotswap_200

Connections:
unnamed: D311.2 (A), K31.2
col1: K31.1; also elsewhere on the board
led_col1: D31.1 (A); also elsewhere on the board
led_row3A: D31.4 (BK); also elsewhere on the board
led_row3B: D31.3 (GK); also elsewhere on the board
led_row3C: D31.2 (RK); also elsewhere on the board
row3: D311.1 (K); also elsewhere on the board

Parts of its further copies:
D21, D41, D51, D65, D66: LED_ARGB; MX_RGB
D211, D411, D511, D651, D661: D; D_SOD-123
K21, K41, K51, K65, K66: KEYSW; MX_switch_hotswap_200

Connections of its further copies:
unnamed: D211.2 (A), K21.2
unnamed: D411.2 (A), K41.2
unnamed: D511.2 (A), K51.2
unnamed: D651.2 (A), K65.2
unnamed: D661.2 (A), K66.2
col1: K21.1, K41.1, K51.1; also elsewhere on the board
col5: K65.1; also elsewhere on the board
col6: K66.1; also elsewhere on the board
led_col1: D21.1 (A); also elsewhere on the board
led_col9: D41.1 (A), D51.1 (A); also elsewhere on the board
led_col13: D65.1 (A); also elsewhere on the board
led_col14: D66.1 (A); also elsewhere on the board
led_row1A: D41.4 (BK); also elsewhere on the board
led_row1B: D41.3 (GK); also elsewhere on the board
led_row1C: D41.2 (RK); also elsewhere on the board
led_row2A: D21.4 (BK), D51.4 (BK); also elsewhere on the board
led_row2B: D21.3 (GK), D51.3 (GK); also elsewhere on the board
led_row2C: D21.2 (RK), D51.2 (RK); also elsewhere on the board
led_row3A: D65.4 (BK), D66.4 (BK); also elsewhere on the board
led_row3B: D65.3 (GK), D66.3 (GK); also elsewhere on the board
led_row3C: D65.2 (RK), D66.2 (RK); also elsewhere on the board
row2: D211.1 (K); also elsewhere on the board
row4: D411.1 (K); also elsewhere on the board
row5: D511.1 (K); also elsewhere on the board
row6: D651.1 (K), D661.1 (K); also elsewhere on the board


Parts:
D31: LED_ARGB; MX_RGB
D311: D; D_SOD-123
K31: KEYSW; MX_switch_hotswap_125

Connections:
unnamed: D311.2 (A), K31.2
col1: K31.1; also elsewhere on the board
led_col1: D31.1 (A); also elsewhere on the board
led_row3A: D31.4 (BK); also elsewhere on the board
led_row3B: D31.3 (GK); also elsewhere on the board
led_row3C: D31.2 (RK); also elsewhere on the board
row3: D311.1 (K); also elsewhere on the board

Parts of its further copies:
D21, D41, D51, D61, D62, D63, D64: LED_ARGB; MX_RGB
D211, D411, D511, D611, D621, D631, D641: D; D_SOD-123
K21, K41, K51, K61, K62, K63, K64: KEYSW; MX_switch_hotswap_125

Connections of its further copies:
unnamed: D211.2 (A), K21.2
unnamed: D411.2 (A), K41.2
unnamed: D511.2 (A), K51.2
unnamed: D611.2 (A), K61.2
unnamed: D621.2 (A), K62.2
unnamed: D631.2 (A), K63.2
unnamed: D641.2 (A), K64.2
col1: K21.1, K41.1, K51.1, K61.1; also elsewhere on the board
col2: K62.1; also elsewhere on the board
col3: K63.1; also elsewhere on the board
col4: K64.1; also elsewhere on the board
led_col1: D21.1 (A); also elsewhere on the board
led_col9: D41.1 (A), D51.1 (A), D61.1 (A); also elsewhere on the board
led_col10: D62.1 (A); also elsewhere on the board
led_col11: D63.1 (A); also elsewhere on the board
led_col12: D64.1 (A); also elsewhere on the board
led_row1A: D41.4 (BK); also elsewhere on the board
led_row1B: D41.3 (GK); also elsewhere on the board
led_row1C: D41.2 (RK); also elsewhere on the board
led_row2A: D21.4 (BK), D51.4 (BK); also elsewhere on the board
led_row2B: D21.3 (GK), D51.3 (GK); also elsewhere on the board
led_row2C: D21.2 (RK), D51.2 (RK); also elsewhere on the board
led_row3A: D61.4 (BK), D62.4 (BK), D63.4 (BK), D64.4 (BK); also elsewhere on the board
led_row3B: D61.3 (GK), D62.3 (GK), D63.3 (GK), D64.3 (GK); also elsewhere on the board
led_row3C: D61.2 (RK), D62.2 (RK), D63.2 (RK), D64.2 (RK); also elsewhere on the board
row2: D211.1 (K); also elsewhere on the board
row4: D411.1 (K); also elsewhere on the board
row5: D511.1 (K); also elsewhere on the board
row6: D611.1 (K), D621.1 (K), D631.1 (K), D641.1 (K); also elsewhere on the board

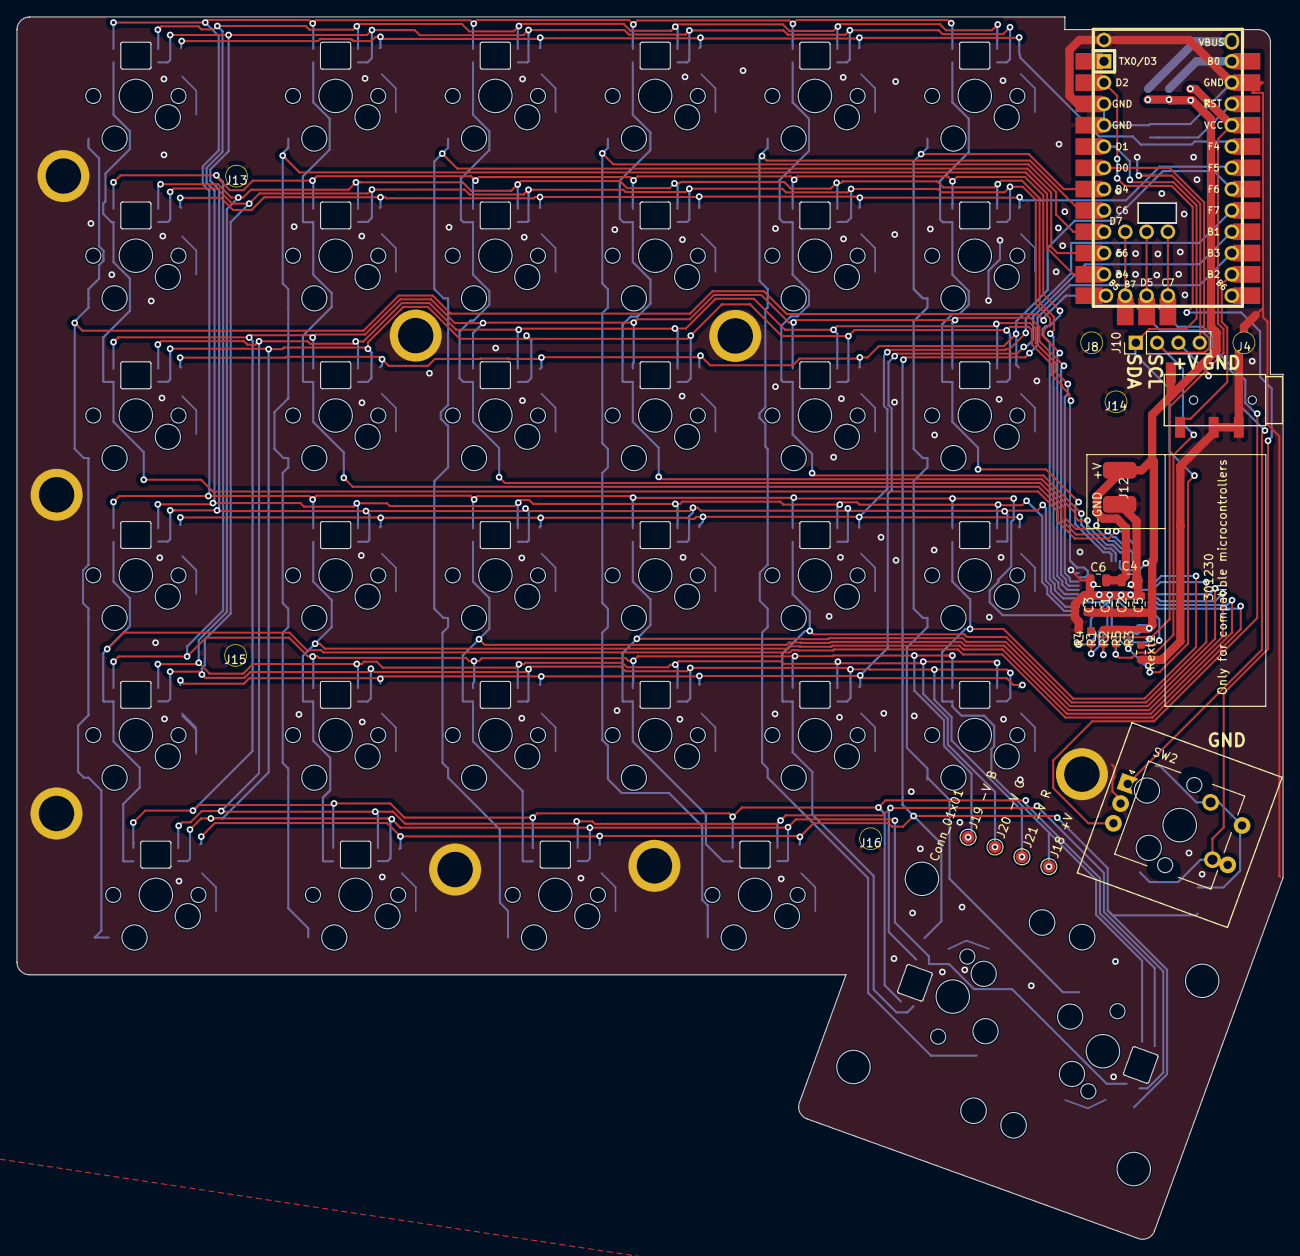
[picture p16: board ortho_half.kicad_pcb from above]

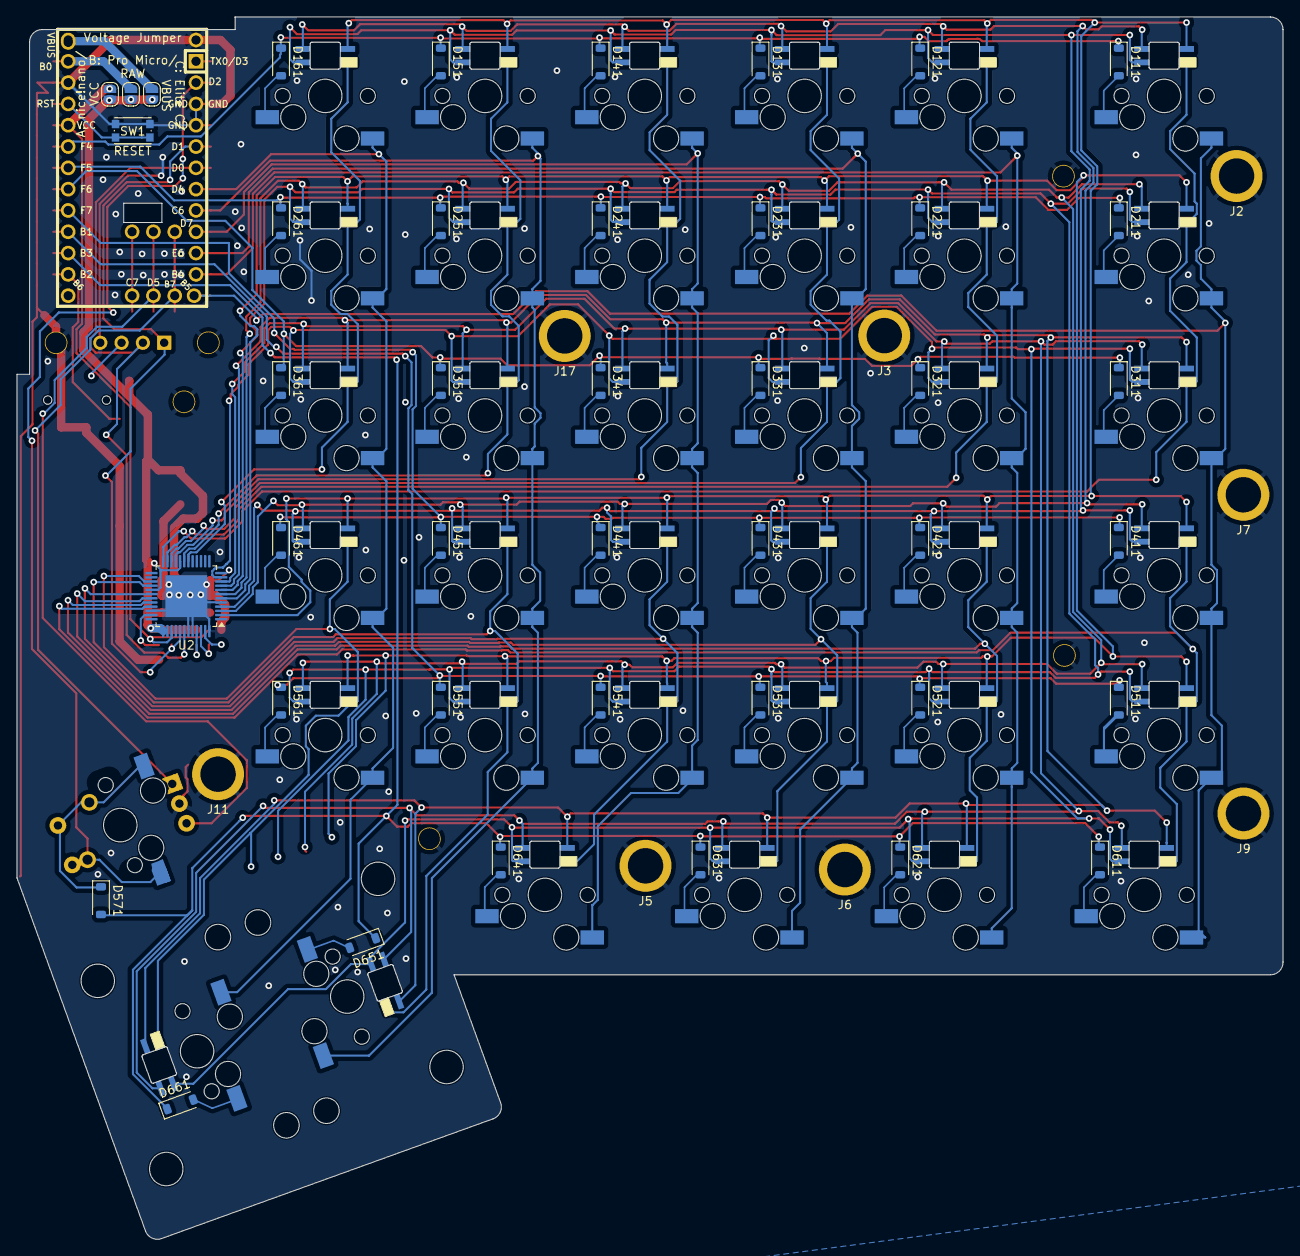
[picture p17: board ortho_half.kicad_pcb from below]

Board: 2 copper layers, 150.9 x 145.7 mm, 149 parts (50 on the bottom side), 86 nets.
