vladkvit/orthograph_keyboard/right/ortho_right.kicad_pcb

## KiCad design right/ortho_right.kicad_pcb (2022-06-20)

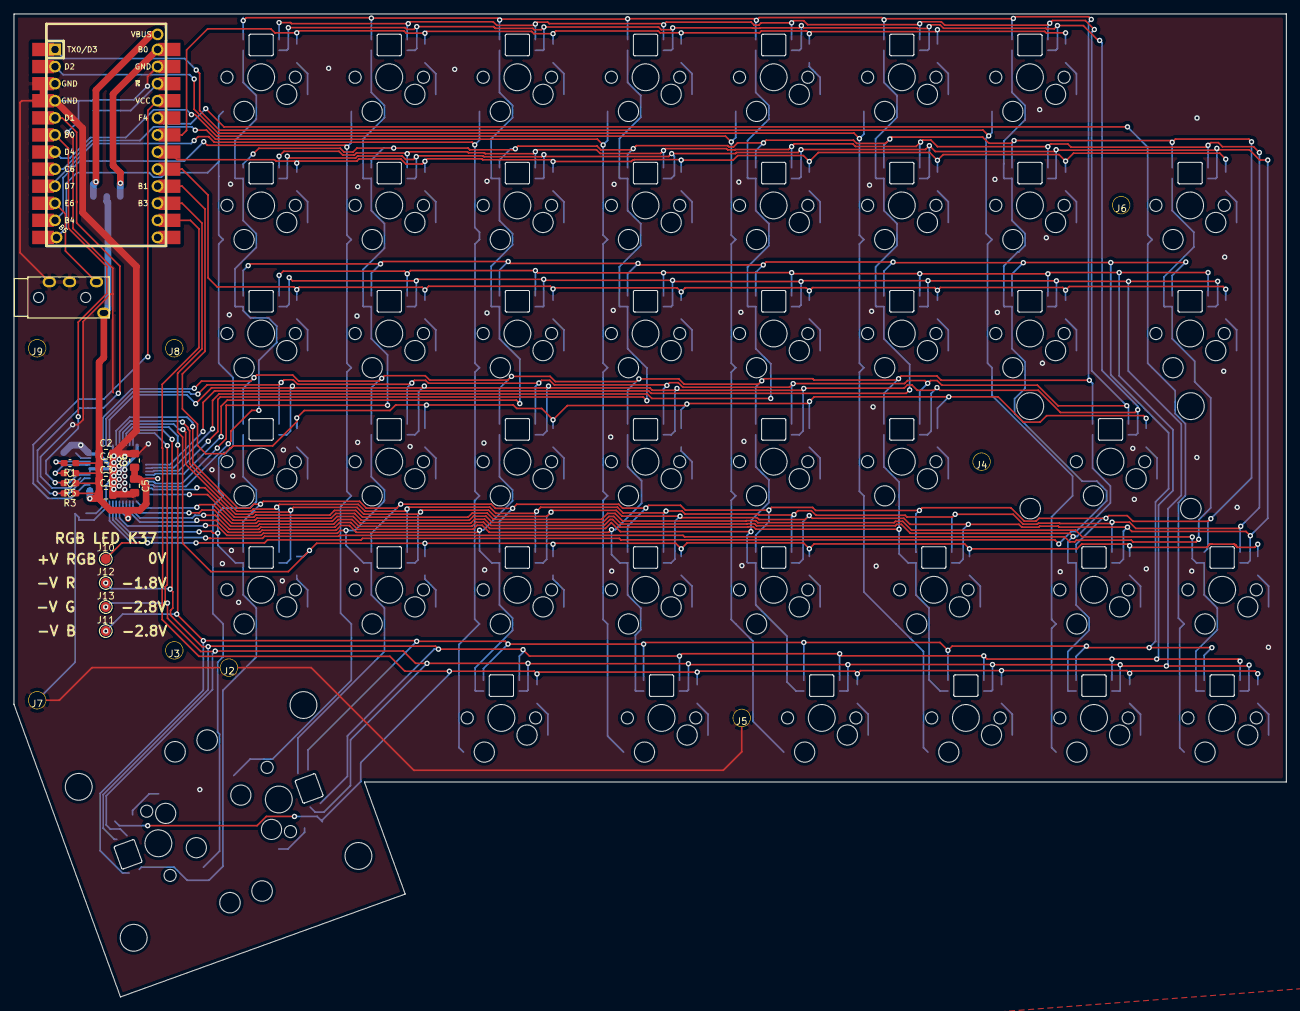
[picture p18: board ortho_right.kicad_pcb from above]

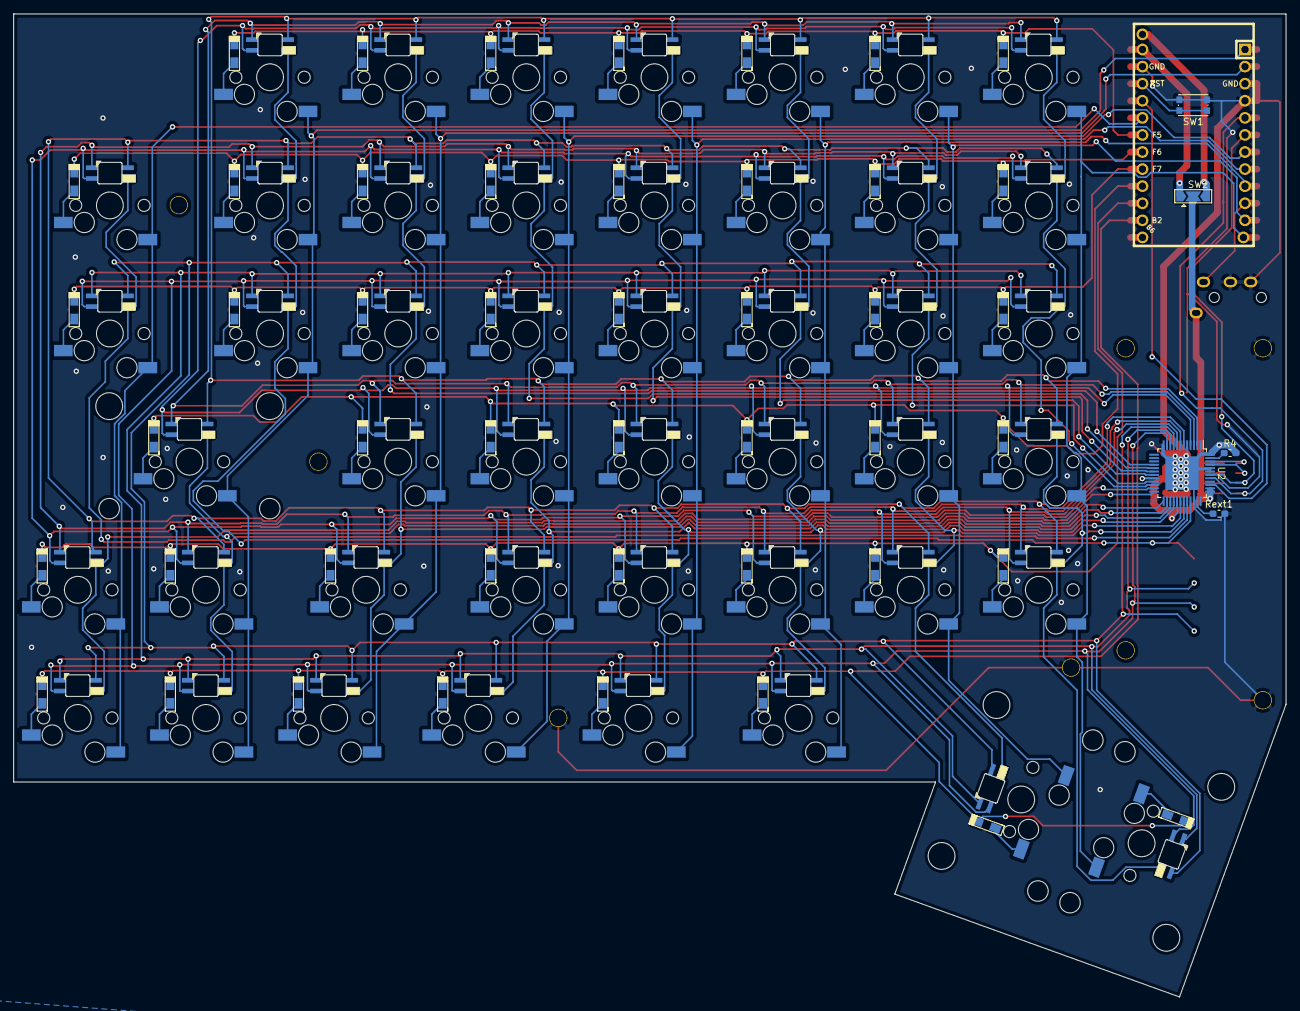
[picture p19: board ortho_right.kicad_pcb from below]

Board: 2 copper layers, 189.2 x 146.1 mm, 75 parts (5 on the bottom side), 98 nets.

Parts:
C1, C2, C3, C4, C5, C6: CP; C_0805_2012Metric_Pad1.15x1.40mm_HandSolder
J1: AudioJack4; TRRS-PJ-320A
J2, J3, J4, J5, J6, J7, J8, J9: Conn_01x01; m2.5_hole
J10, J11, J12, J13: Conn_01x01; TestPoint_Pad_D1.5mm
K11, K12, K13, K14, K15, K16, K17, K21, K22, K23, K24, K25, K26, K27, K31, K32, K33, K34, K35, K36, K37, K41, K42, K43, K44, K45, K46, K51, K52, K53, K54, K55, K57, K58, K66, K67, K68: KEYSW_RGB; Hybrid_PCB_100H_hotswap_diode_RGB_rot
K28, K38, K56: KEYSW_RGB; Hybrid_PCB_150H_hotswap_diode_RGB_rot
K47: KEYSW_RGB; Hybrid_PCB_225H_hotswap_diode_RGB
K61, K62: KEYSW_RGB; Hybrid_PCB_200H_hotswap_diode_RGB
K63, K64, K65: KEYSW_RGB; Hybrid_PCB_125H_hotswap_diode_RGB_rot
R1, R2, R4: R100k; R_0603_1608Metric_Pad1.05x0.95mm_HandSolder
R3, R5: R1k; R_0603_1608Metric_Pad1.05x0.95mm_HandSolder
Rext1: R20k; R_0603_1608Metric_Pad1.05x0.95mm_HandSolder
SW1: SW_PUSH_RESET; SW_Push_1P1T_NO_CK_KMR2
SW2: SW_SPDT_MSM; SolderJumper-3_P2.0mm_Open_TrianglePad1.0x1.5mm
U1: EliteC; Elite-C-castellated-24pin-holes
U2: IS31FL3733-TQ; TQFP-48-1EP_7x7mm_P0.5mm_EP5x5mm

Connections:
GND: C1.2, C2.2, C3.2, C4.2, C5.2, C6.2, J1.R2, J1.S, J2.1, J5.1, J7.1, J9.1, R4.2, Rext1.2, SW1.2, U1.3, U1.4, U1.23, U2.5, U2.12, U2.34, U2.43, U2.44, U2.48, U2.49
INTB: R2.2, U2.45
unnamed: K11.2, K11.4
unnamed: K12.2, K12.4
unnamed: K13.2, K13.4
unnamed: K14.2, K14.4
unnamed: K15.2, K15.4
unnamed: K16.2, K16.4
unnamed: K17.2, K17.4
unnamed: K21.2, K21.4
unnamed: K22.2, K22.4
unnamed: K23.2, K23.4
unnamed: K24.2, K24.4
unnamed: K25.2, K25.4
unnamed: K26.2, K26.4
unnamed: K27.2, K27.4
unnamed: K28.2, K28.4
unnamed: K31.2, K31.4
unnamed: K32.2, K32.4
unnamed: K33.2, K33.4
unnamed: K34.2, K34.4
unnamed: K35.2, K35.4
unnamed: K36.2, K36.4
unnamed: K37.2, K37.4
unnamed: K38.2, K38.4
unnamed: K41.2, K41.4
unnamed: K42.2, K42.4
unnamed: K43.2, K43.4
unnamed: K44.2, K44.4
unnamed: K45.2, K45.4
unnamed: K46.2, K46.4
unnamed: K47.2, K47.4
unnamed: K51.2, K51.4
unnamed: K52.2, K52.4
unnamed: K53.2, K53.4
unnamed: K54.2, K54.4
unnamed: K55.2, K55.4
unnamed: K56.2, K56.4
unnamed: K57.2, K57.4
unnamed: K58.2, K58.4
unnamed: K61.2, K61.4
unnamed: K62.2, K62.4
unnamed: K63.2, K63.4
unnamed: K64.2, K64.4
unnamed: K65.2, K65.4
unnamed: K66.2, K66.4
unnamed: K67.2, K67.4
unnamed: K68.2, K68.4
unnamed: R4.1, U2.47
unnamed: Rext1.1, U2.35
unnamed: SW1.1, U1.22
unnamed: SW2.1, U1.24
unnamed: SW2.3, U1.30
SCL: R5.2, U1.6, U2.42
SDA: R3.2, U1.5, U2.41
SDB: R1.2, U2.46
VCC: C1.1, C2.1, C3.1, C4.1, C5.1, C6.1, J1.T, R1.1, R2.1, R3.1, R5.1, SW2.2, U2.20, U2.29, U2.37, U2.38
VIO: U1.21, U2.39
col1: K11.1, K21.1, K31.1, K41.1, K51.1, K61.1, U1.12
col2: K12.1, K22.1, K32.1, K42.1, K52.1, K62.1, U1.11
col3: K13.1, K23.1, K33.1, K43.1, K53.1, K63.1, U1.9
col4: K14.1, K24.1, K34.1, K44.1, K54.1, K64.1, U1.8
col5: K15.1, K25.1, K35.1, K45.1, K55.1, K65.1, U1.7
col6: K16.1, K26.1, K36.1, K46.1, K56.1, K66.1, U1.2
col7: K17.1, K27.1, K37.1, K47.1, K57.1, K67.1, U1.1
col8: K28.1, K38.1, K58.1, K68.1, U1.20
led_col1: K11.5, K21.5, K31.5, U2.22
led_col2: K12.5, K22.5, K32.5, U2.21
led_col3: K13.5, K23.5, K33.5, U2.19
led_col4: K14.5, K24.5, K34.5, U2.18
led_col5: K15.5, K25.5, K35.5, U2.17
led_col6: K16.5, K26.5, K36.5, U2.16
led_col7: J10.1, K17.5, K27.5, K37.5, U2.33
led_col8: K28.5, K38.5, U2.32
led_col9: K41.5, K51.5, K61.5, U2.31
led_col10: K42.5, K52.5, K62.5, U2.30
led_col11: K43.5, K53.5, K63.5, U2.28
led_col12: K44.5, K54.5, K64.5, U2.27
led_col13: K45.5, K55.5, K65.5, U2.26
led_col14: K46.5, K56.5, K66.5, U2.25
led_col15: K47.5, K57.5, K67.5, U2.24
led_col16: K58.5, K68.5, U2.23
led_row1A: K11.8, K12.8, K13.8, K14.8, K15.8, K16.8, K17.8, K41.8, K42.8, K43.8, K44.8, K45.8, K46.8, K47.8, U2.2
led_row1B: K11.7, K12.7, K13.7, K14.7, K15.7, K16.7, K17.7, K41.7, K42.7, K43.7, K44.7, K45.7, K46.7, K47.7, U2.3
led_row1C: K11.6, K12.6, K13.6, K14.6, K15.6, K16.6, K17.6, K41.6, K42.6, K43.6, K44.6, K45.6, K46.6, K47.6, U2.4
led_row2A: K21.8, K22.8, K23.8, K24.8, K25.8, K26.8, K27.8, K28.8, K51.8, K52.8, K53.8, K54.8, K55.8, K56.8, K57.8, K58.8, U2.6
led_row2B: K21.7, K22.7, K23.7, K24.7, K25.7, K26.7, K27.7, K28.7, K51.7, K52.7, K53.7, K54.7, K55.7, K56.7, K57.7, K58.7, U2.7
led_row2C: K21.6, K22.6, K23.6, K24.6, K25.6, K26.6, K27.6, K28.6, K51.6, K52.6, K53.6, K54.6, K55.6, K56.6, K57.6, K58.6, U2.8
led_row3A: J11.1, K31.8, K32.8, K33.8, K34.8, K35.8, K36.8, K37.8, K38.8, K61.8, K62.8, K63.8, K64.8, K65.8, K66.8, K67.8, K68.8, U2.9
led_row3B: J12.1, K31.7, K32.7, K33.7, K34.7, K35.7, K36.7, K37.7, K38.7, K61.7, K62.7, K63.7, K64.7, K65.7, K66.7, K67.7, K68.7, U2.10
led_row3C: J13.1, K31.6, K32.6, K33.6, K34.6, K35.6, K36.6, K37.6, K38.6, K61.6, K62.6, K63.6, K64.6, K65.6, K66.6, K67.6, K68.6, U2.11
row1: K11.3, K12.3, K13.3, K14.3, K15.3, K16.3, K17.3, U1.19
row2: K21.3, K22.3, K23.3, K24.3, K25.3, K26.3, K27.3, K28.3, U1.18
row3: K31.3, K32.3, K33.3, K34.3, K35.3, K36.3, K37.3, K38.3, U1.17
row4: K41.3, K42.3, K43.3, K44.3, K45.3, K46.3, K47.3, U1.16
row5: K51.3, K52.3, K53.3, K54.3, K55.3, K56.3, K57.3, K58.3, U1.15
row6: K61.3, K62.3, K63.3, K64.3, K65.3, K66.3, K67.3, K68.3, U1.14
serial: J1.R1, U1.10
