vladkvit/orthograph_keyboard/(commit log)

2021-03-09 v0.1 prototype pcb, works well
    [ortho_half-Eco2_User.dxf, ortho_half-Edge_Cuts.dxf, ortho_right-Eco2_User.dxf, ortho_right-Edge_Cuts inkscape.dxf, ortho_right-Edge_Cuts.dxf, ortho_right-NPTH-drl_map.dxf, ortho_right-PTH-drl_map.dxf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]
2021-06-19 Updated schematic of left side split.
    [Controller.sch, switches.sch]
2021-06-20 Some initial work on the PCB update.
    [Controller.sch, ortho_half.kicad_pcb, switches.sch]
2021-06-20 More PCB updates
    [Controller.sch, ortho_half.kicad_pcb]
2021-06-21 More PCB stuff
    [ortho_half.kicad_pcb]
2021-06-27 A bunch of changes to left half of PCB in order to make room for battery and various connectors. Also added a switch and extra connector on the schematic.
    [Controller.sch, ortho_half.kicad_pcb, switches.sch]
2021-06-27 Moved around components and placed the JST power connectors
    [Controller.sch, ortho_half.kicad_pcb, switches.sch]
2021-08-31 Lots of changes to left side of controller. Should be pretty close to rev2
    [Controller.sch, ortho_half.kicad_pcb]
2021-09-06 Minor updates
    [ortho_half.kicad_pcb]
2022-06-20 Kicad 6 migration; other fixes
    [Controller.kicad_sch, LEDs.kicad_sch, LEDs.sch, ortho_half-Eco2_User.dxf, ortho_half-Edge_Cuts.dxf, ortho_half.kicad_pcb, ortho_half.kicad_sch, ortho_right.kicad_pcb]
2024-07-21 Broke out keys into individual components so that the BOM and pick and place are easier to generate.
    [Controller.kicad_sch, LEDs.kicad_sch, hierarchical_keys.kicad_pcb, hierarchical_keys.kicad_sch, hierarchical_keys_125.kicad_pcb, hierarchical_keys_125.kicad_sch, hierarchical_keys_150.kicad_pcb, hierarchical_keys_150.kicad_sch]
2025-03-23 Kicad 9 upgrade.
    [Controller.kicad_sch, hierarchical_keys.kicad_sch, hierarchical_keys_125.kicad_sch, hierarchical_keys_150.kicad_sch, hierarchical_keys_200.kicad_sch, ortho_half.kicad_pcb, ortho_half.kicad_sch, switches.kicad_sch]
2025-03-25 Fix SDA/SCL bug
    [Controller.kicad_sch, ortho_half.kicad_pcb]
2025-12-19 checking stuff in
    [ortho_half.kicad_pcb]
